enewhall/Mechatronics/connect to Raspberry Pi.txt

ssh pi@169.254.216.2
password: raspberry
