enewhall/Mechatronics/portfolio.html

# 16-778, 18-578, 24-778 Mechatronic Design

# Pre-Tinning Machine

# Project Portfolio

Group G
Eric Newhall (enewhall)
Guillermo Cidre (gmcidre)
Christian Heaney-Secord (cheaneys)
Michael O'Connor (mkoconno)

## Portfolio Overview

- Problem Description
  - Overview
  - Requirements
- System Design
  - Architecture
  - Part Separator
  - Vision Processing
  - Part Placer
  - Tray Positioner
  - Flux and Wire Dispensor
- System Implementation
  - Software
  - Part Separator
  - Vision Processing
  - Part Placer
  - Tray Positioner
  - Flux and Wire Dispensor
- Project Management
  - Team
  - Parts List and Budget
  - Schedule
    - Presenter Schedule
  - Issues Log
- Media
  - Media
- Documents
  - CAD
  - Design Proposal
  - Final Design Proposal
  - Presentations
  - Sequence Diagrams
  - State Charts
  - Lab Reports
