enewhall/Mechatronics/portfolio/new_page_template.html

# Mechatronics - Page Title

16-778, 18-578, 24-778 Spring 2015
Group G
Eric Newhall (enewhall)
Guillermo Cidre (gmcidre)
Christian Heaney-Secord (cheaneys)
Michael O'Connor (mkoconno)

## Title

Remember to change the title in the HTML header.

More contents here.
