enewhall/Mechatronics/portfolio/Media/Media.html

# Mechatronics - Media

16-778, 18-578, 24-778 Spring 2015
Group G
Eric Newhall (enewhall)
Guillermo Cidre (gmcidre)
Christian Heaney-Secord (cheaneys)
Michael O'Connor (mkoconno)

## Pictures

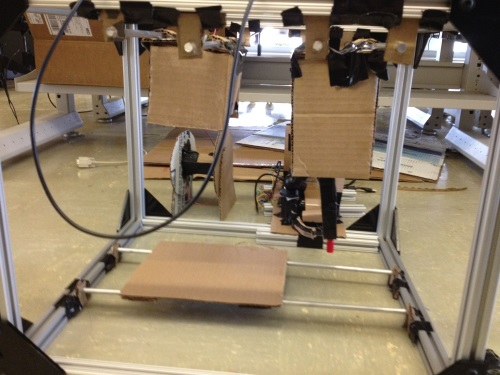
[picture p1: portfolio/Media/mockup1.jpeg]
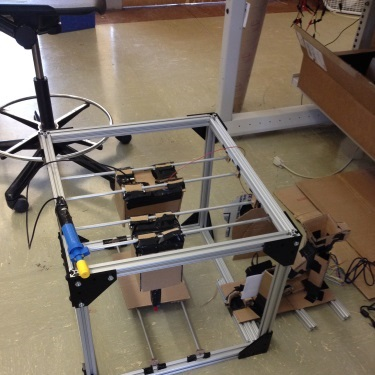
[picture p2: portfolio/Media/mockup2.jpeg]
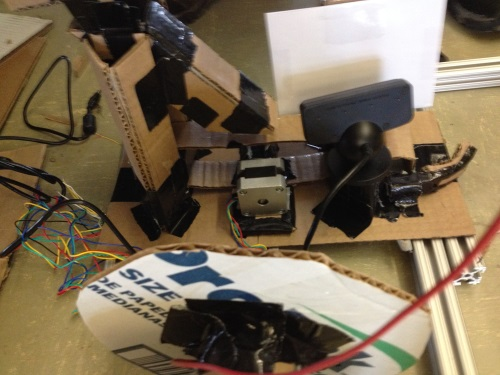
[picture p3: portfolio/Media/mockup3.jpeg]
Mockup (1/3)  | Mockup (2/3)  | Mockup (3/3) 

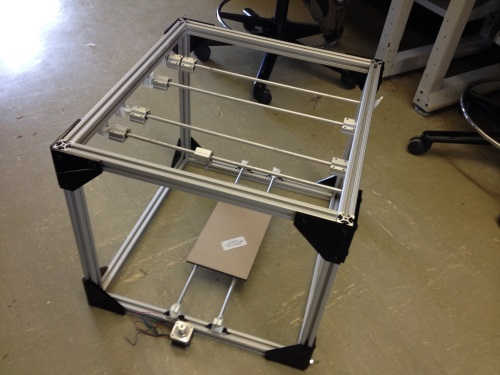
[picture p4: portfolio/Media/Frame_With_Rails.jpeg]
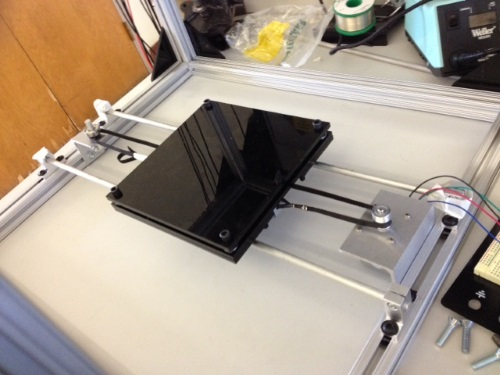
[picture p5: portfolio/Media/rail.JPG]
rail
Frame With Rails  | Rail For Tray System 

Part Placer
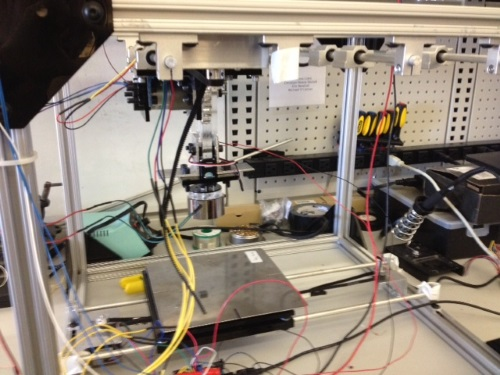
[picture p6: portfolio/Media/part_placer.png]


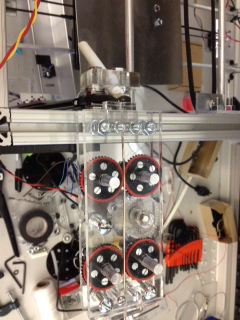
[picture p7: portfolio/Media/wire_feeder.jpeg]
wire_feeder
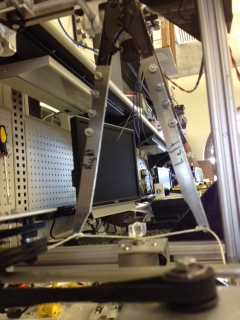
[picture p8: portfolio/Media/wire_cutter.jpeg]
wire_cutter
Wire Feeder  | Wire Cutter 

## Videos

Full Project Demo

(https://youtu.be/HHD21gbO3Bo)
