enewhall/Mechatronics/portfolio/Systems/Systems.html

# Mechatronics - Systems

16-778, 18-578, 24-778 Spring 2015
Group x
Eric Newhall (enewhall)
Guillermo Cidre (gmcidre)
Christian Heaney-Secord (cheaneys)
Michael O'Connor (mkoconno)

## Feeder

## Orienter

## Part Placer

## Flux Placer

## Wire Placer
