enewhall/Mechatronics/portfolio/System_Implementation/Code/Code.html

# Mechatronics - Software

16-778, 18-578, 24-778 Spring 2015
Group G
Eric Newhall (enewhall)
Guillermo Cidre (gmcidre)
Christian Heaney-Secord (cheaneys)
Michael O'Connor (mkoconno)

## Software

Vision Processing Software:
get_BW_image.pi

System Demo Software:
CameraState.ino
FluxDispensorState.ino
LEDState.ino
PartPlacerState.ino
PreTinnerSoftware.ino
revRelState.ino
GlobalVariables.h
SupportFunctionsStructs.h
