enewhall/Mechatronics/portfolio/Documents/State_Charts/State_Charts.html

# Mechatronics - State Charts

16-778, 18-578, 24-778 Spring 2015
Group G
Eric Newhall (enewhall)
Guillermo Cidre (gmcidre)
Christian Heaney-Secord (cheaneys)
Michael O'Connor (mkoconno)

## State Charts

### 1. Camera and Part Seperator

Controls:

- vibration_motor
- conveyer_belt
- flipper_magnet
- flipper_servo

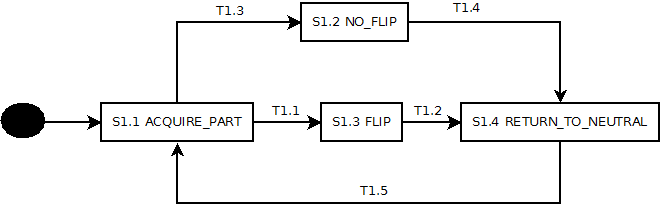
[picture p9: portfolio/Documents/State_Charts/S1.png]


Transition | Condition
T1.1 | image_orientation == 3 || image_orientation == 4
T1.2 | timing
T1.3 | image_orientation == 1 || image_orientation == 2
T1.4 | timing
T1.5 | timing

State | Description | Actions
S1.1 ACQUIRE_PART | Move the conveyer belt until the next part can be seen | vibration_motor = on conveyer_belt = on flipper_magnet = on flipper_servo = off
S1.2 NO_FLIP | Get the part to pick up location | vibration_motor = off conveyer_belt = off flipper_magnet = off flipper_servo = foward
S1.3 FLIP | Flip the part to pick up location | vibration_motor = off conveyer_belt = off flipper_magnet = on flipper_servo = foward
S1.4 RETURN_TO_NEUTRAL | Move servo back to initial position | vibration_motor = off conveyer_belt = off flipper_magnet = off flipper_servo = reverse

### 2. Part Placer

Controls:

- placer_rail
- dc_rack
- placer_magnet
- placer_servo
- tray_rail

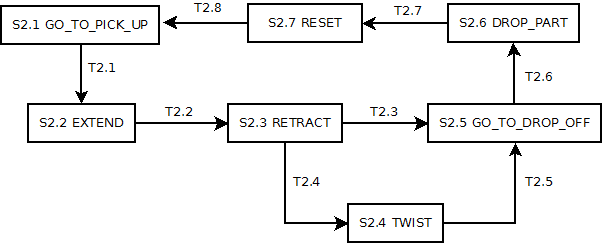
[picture p10: portfolio/Documents/State_Charts/S2.png]


Transition | Condition
T2.1 | placer_loc == PICK_UP_LOC && image_orientation != 0
T2.2 | timing
T2.3 | (image_orientation == 1 || image_orientation == 3) && placer_limit_switch == true
T2.4 | (image_orientation == 2 || image_orientation == 4) && placer_limit_switch == true
T2.5 | placer_loc == DROP_OFF_LOC
T2.6 | timing && tray_loc == TRAY_DROP_OFF
T2.7 | timing
T2.8 | placer_limit_switch == true

State | Description | Actions
S2.1 GO_TO_PICK_UP | move rail to pick up location by camera and wait for part | placer_rail = move to pick up dc_rack = off placer_magnet = off placer_servo = off tray_rail = move to working pos
S2.2 EXTEND | lower arm to grab part | placer_rail = move to pick up dc_rack = lower placer_magnet = off placer_servo = off tray_rail = move to working pos
S2.3 RETRACT | raise arm holding part | placer_rail = move to pick up dc_rack = raise placer_magnet = on placer_servo = off tray_rail = move to working pos
S2.4 TWIST | rotate arm 180 degrees to correct orientation | placer_rail = move to pick up dc_rack = off placer_magnet = on placer_servo = on tray_rail = move to working pos
S2.5 GO_TO_DROP_OFF | move tray and part placer to correct location | placer_rail = move to drop off dc_rack = off placer_magnet = on placer_servo = off tray_rail = move to tray drop
S2.6 DROP_PART | place part on tray | placer_rail = move to drop off dc_rack = lower placer_magnet = on placer_servo = off tray_rail = move to tray drop
S2.7 RESET | place part on tray | placer_rail = move to drop off dc_rack = raise placer_magnet = off placer_servo = off tray_rail = move to tray drop
