enewhall/Mechatronics/portfolio/Project_Management/Team/Team.html

# Mechatronics - Team

16-778, 18-578, 24-778 Spring 2015
Group G
Eric Newhall (enewhall)
Guillermo Cidre (gmcidre)
Christian Heaney-Secord (cheaneys)
Michael O'Connor (mkoconno)

## Team

### Guillermo Cidre(ECE) - Analog design and serial communications

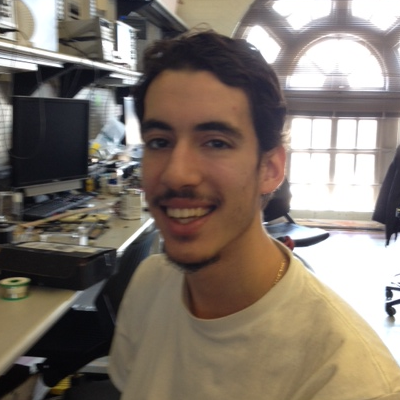
[picture p11: portfolio/Project_Management/Team/gc.png]
Guillermo Cidre


### Michael O'Connor(MechE) - Flux dispenser and wire cutting and placement

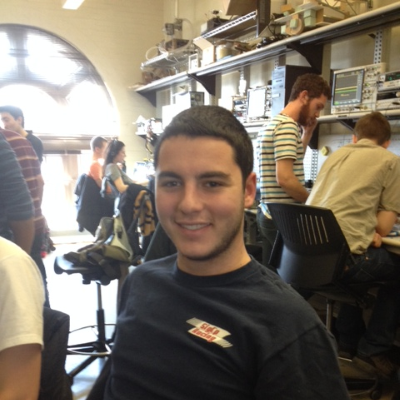
[picture p12: portfolio/Project_Management/Team/mo.png]
Michael O'Connor


### Christian Heaney-Secord(MechE) - Hopper design and part oreientor

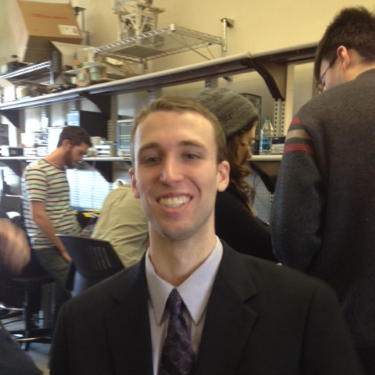
[picture p13: portfolio/Project_Management/Team/ch.png]
Christian Heaney-Secord


### Eric Newhall(ECE) - Vision processing and website design

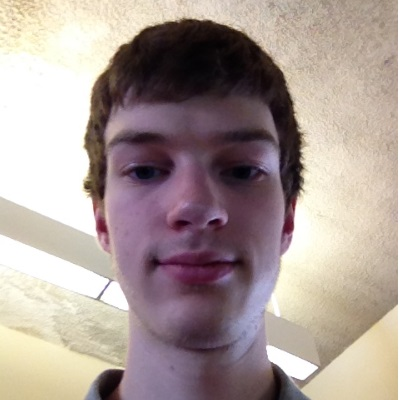
[picture p14: portfolio/Project_Management/Team/en.png]
Eric Newhall
