enewhall/Mechatronics/portfolio/Project_Management/Schedule/Schedule.html

# Mechatronics - Schedule

16-778, 18-578, 24-778 Spring 2015
Group G
Eric Newhall (enewhall)
Guillermo Cidre (gmcidre)
Christian Heaney-Secord (cheaneys)
Michael O'Connor (mkoconno)

## Schedule

Due Date | Project | Leader
Feb 1 | Complete parts order | All
Feb 1 | Prototype hopper | Christian Heaney-Secord
Feb 8 | Migrate deisgn proposal info to website | Eric Newhall
Feb 8 | Test vision processing system | Eric Newhall
Feb 15 | Serial communication between RP and Arduino | Guillermo Cidre
Feb 15 | Build and test electromagnet part placer | Christian Heaney-Secord
Feb 22 | Wire and test stepper motors | Guillermo Cidre
Feb 22 | Complete part re-orientator and integrate with hopper | Christian Heaney-Secord
March 1 | Complete conveyor belt | Christian Heaney-Secord
March 1 | Finalize vision processing | Eric Newhall
March 1 | Midsemester Presentations | All
March 8 | Complete rail systems | Michael O'Connor
March 8 | Complete tray positioner | Christian Heaney-Secord
March 15 | Spring Break | Off
March 22 | Prototype flux extruder | Michael O'Connor
March 22 | Complete and integrate part placer | Christian Heaney-Secord
March 29 | Complete and test wire cutting mechanism | Michael O'Connor
April 5 | Integrate flux extruder and wire cutter onto rails | Michael O'Connor
April 12 | Test and calibrate system | All
April 19 | Replace original prototypes with refined parts | Michael O'Connor
April 26 | Re-calibrate and test extensively | All
May 3 | Prepare final report and presentation | All
