enewhall/Mechatronics/portfolio/Documents/Sequence_Diagrams/Sequence_Diagrams.html

# Mechatronics - Sequence Diagrams

16-778, 18-578, 24-778 Spring 2015
Group G
Eric Newhall (enewhall)
Guillermo Cidre (gmcidre)
Christian Heaney-Secord (cheaneys)
Michael O'Connor (mkoconno)

## Use Cases

- 1.1 Move part from separator to camera
- 2.1 Pick up part from camera (correct orientation)
- 2.2 Pick up part from camera (180 degrees flipped)
- 2.3 Pick up part from camera (upsidedown)
- 2.4 Pick up part from camera (upsidedown and 180 degrees flipped)
- 3.1 Place part on tray
- 4.1 Place flux on part
- 5.1 Dispense wire onto part

### 1.1 Move part from separator to camera

#### Initial Conditions

- Part is in hopper
- Vibration motor is off
- Conveyer belt is stationary

#### Final Conditions

- Part is in frint of camera
- Vibration motor is off
- Conveyer belt is stationary

#### Sequence Diagram

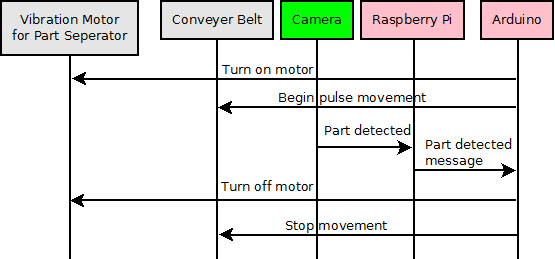
[picture p15: portfolio/Documents/Sequence_Diagrams/D1_1.png]
D1.1


### 2.1 Pick up part from camera (correct orientation)

#### Initial Conditions

- Part is front of camera in correct orientation
- Magnet for part placer is off
- Flipper Magnet is on
- Part placer located over tray
- Placer arm is retracted
- Flipper in neutral position

#### Final Conditions

- Magnet for part placer is on
- Flipper Magnet is on
- Part placer located over camera
- Placer arm is retracted
- Flipper in neutral position

#### Sequence Diagram

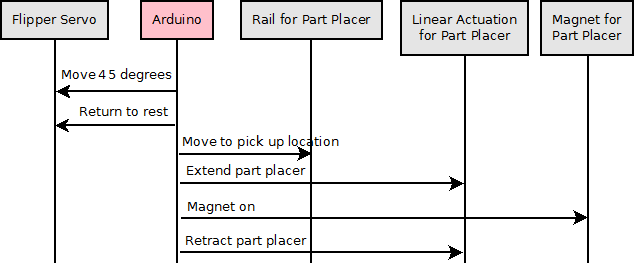
[picture p16: portfolio/Documents/Sequence_Diagrams/D2_1.png]
D2.1


### 2.2 Pick up part from camera (180 degrees flipped)

#### Initial Conditions

- Part is front of camera but is 180 degrees flipped
- Magnet for part placer is off
- Flipper Magnet is on
- Part placer located over tray
- Placer arm is retracted
- Flipper in neutral position

#### Final Conditions

- Magnet for part placer is on
- Flipper Magnet is on
- Part placer located over camera
- Placer arm is retracted
- Flipper in neutral position

#### Sequence Diagram

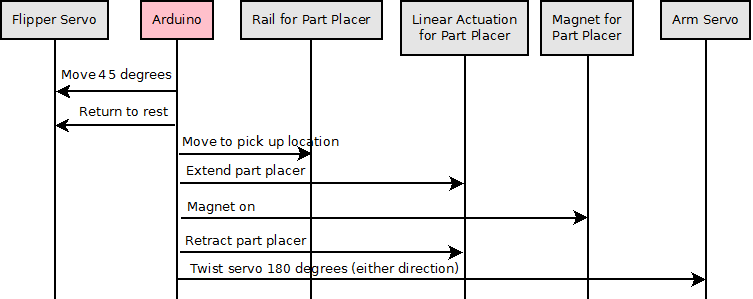
[picture p17: portfolio/Documents/Sequence_Diagrams/D2_2.png]
D2.2


### 2.3 Pick up part from camera (upsidedown)

#### Initial Conditions

- Part is front of camera but upsidedown
- Magnet for part placer is off
- Flipper Magnet is on
- Part placer located over tray
- Placer arm is retracted
- Flipper in neutral position

#### Final Conditions

- Magnet for part placer is on
- Flipper Magnet is on
- Part placer located over camera
- Placer arm is retracted
- Flipper in neutral position

#### Sequence Diagram

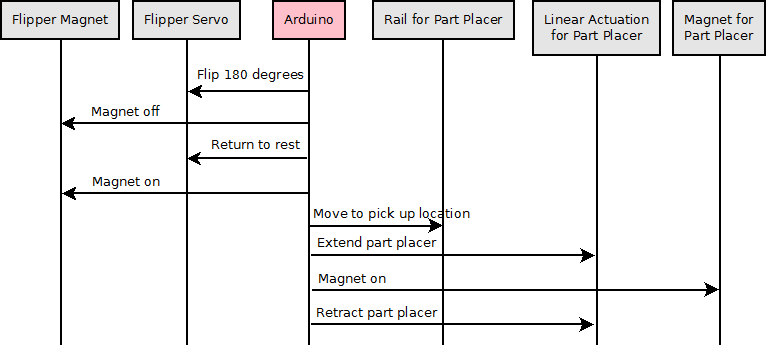
[picture p18: portfolio/Documents/Sequence_Diagrams/D2_3.png]
D2.3


### 2.4 Pick up part from camera (upsidedown and 180 degrees flipped)

#### Initial Conditions

- Part is front of camera but upsidedown and 180 degrees flipped
- Magnet for part placer is off
- Flipper Magnet is on
- Part placer located over tray
- Placer arm is retracted
- Flipper in neutral position

#### Final Conditions

- Magnet for part placer is on
- Flipper Magnet is on
- Part placer located over camera
- Placer arm is retracted
- Flipper in neutral position

#### Sequence Diagram

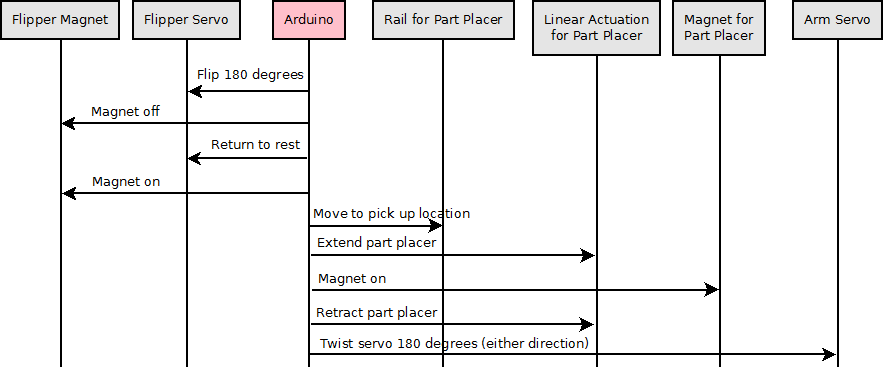
[picture p19: portfolio/Documents/Sequence_Diagrams/D2_4.png]
D2.4


### 3.1 Place part on tray

#### Initial Conditions

- part is being held by magnet
- part is correct orientation
- linear actuator is retracted

#### Final Conditions

- magnet is off
- part is on tray
- linear actuator is retracted

#### Sequence Diagram

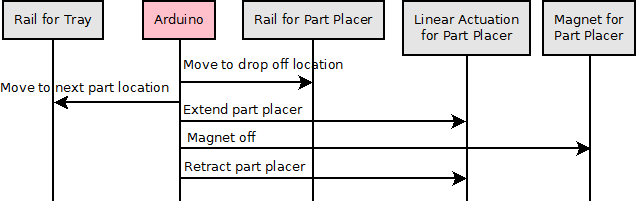
[picture p20: portfolio/Documents/Sequence_Diagrams/D3_1.png]
D3.1


### 4.1 Place flux on part

#### Initial Conditions

- Tray is in front of part placer
- Part has no flux or wire on it

#### Final Conditions

- Tray is in front of flux and wire dispensor
- part has flux and needs wire

#### Sequence Diagram

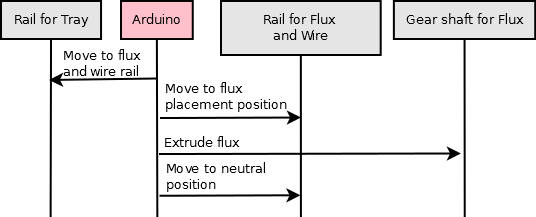
[picture p21: portfolio/Documents/Sequence_Diagrams/D4_1.png]


### 5.1 Dispense wire onto part

#### Initial Conditions

- Tray is in front of flux and wire dispensor
- Part has flux and needs wire

#### Final Conditions

- Tray is in front of flux and wire dispensor
- Part has flux and wire

#### Sequence Diagram

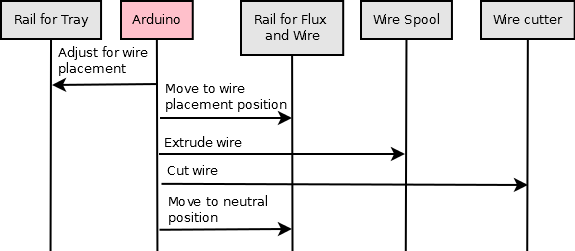
[picture p22: portfolio/Documents/Sequence_Diagrams/D5_1.png]
