enewhall/Mechatronics/portfolio/Problem_Description/Overview/Overview.html

# Mechatronics - Overview

16-778, 18-578, 24-778 Spring 2015
Group G
Eric Newhall (enewhall)
Guillermo Cidre (gmcidre)
Christian Heaney-Secord (cheaneys)
Michael O'Connor (mkoconno)

## Overview

Kennametal is an American supplier of tooling and industrial materials that has a
plant in Victoria, British Columbia, Canada that manufactures saw tips and prepares
them for attachment to a handle through a process known as pre-tinning. In this process
a dab of flux is applied to the surface of a carbide saw tip and then two silver wires
are carefully placed in the flux, oriented along the major diagonal of the saw tip. Once
this process is complete, tinning can occur, in which the wires melt onto the saw tip in
an oven.

The process of pre-tinning saw tips is laborious and meticulous because of the size of
the saw tips and wires that are handled. This work also can have negative health effects
as the repetitive motion can cause strain injuries. Our objective is to design and build
a mechatronic system capable of pre-tinning saw tips, removing the need for this task to
be accomplished manually. In doing so the potential for worker injury will be greatly
reduced, the small wires can be placed with greater accuracy, and there is the potential
that the machine may be able to perform the task significantly faster than a worker.

See Project Requirements
