enewhall/Mechatronics/portfolio/Problem_Description/Requirements/Requirements.html

# Mechatronics - Requirements

16-778, 18-578, 24-778 Spring 2015
Group G
Eric Newhall (enewhall)
Guillermo Cidre (gmcidre)
Christian Heaney-Secord (cheaneys)
Michael O'Connor (mkoconno)

## Explicit Design Requirements:

- 20 parts must be processed in <=5 minutes
- Flux dab must be centered on the part-top centroid and cover 1/4 to 1/3 of the part-top’s surface area
- Must be able to handle at least two different part sizes
- Machine fits within 2’x2’x2’
- The two wires must be placed side by side in the flux dab such that:
  1. Their orientation is along the major diagonal to w/in 5°;
  2. There is no space between them laterally;
  3. Their longitudinal misalignment is <=10%
- The parts will be deposited on a flat output tray in 4 rows of 5 parts each, with the part-tops facing up. Part edges should be at least 1/2” away from the tray edge, and there should be at least 1/4” spacing between the edges of adjacent parts.
- No more than 5% of wires detached or wrongly positioned

## Implied Design Requirements:

- Machine is durable enough such that it can endure a harsh factory environment
- The machine will have a robust design to accommodate any changes or additional requirements of the pre-tinning process
- Design is simple enough such that the basics of the machine will be understood by an assembly worker
- Design will allow easy access for a worker to fix the machine in the event of failure
- Designed such that if a local failure occurs within the machine the remaining functions of the machine will not be compromised
