enewhall/Mechatronics/Labs/Sensor Lab/Potentiometer_notes.pdf

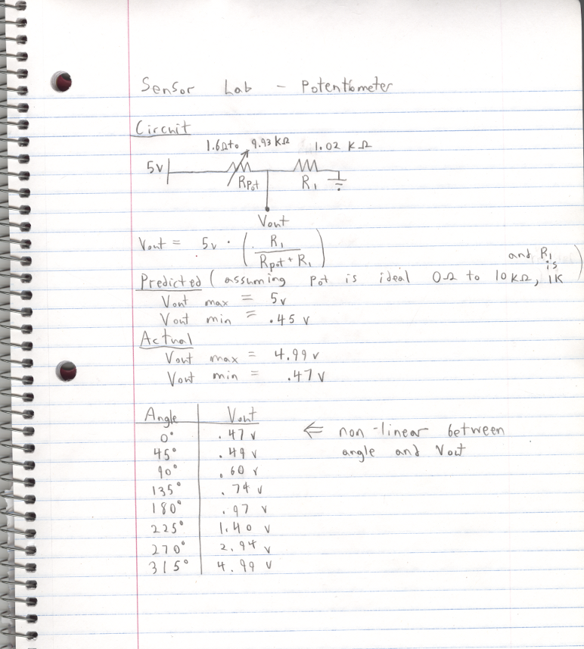
[picture p93: figure]
