enewhall/Mechatronics/Labs/Motor Lab/image(1).jpeg

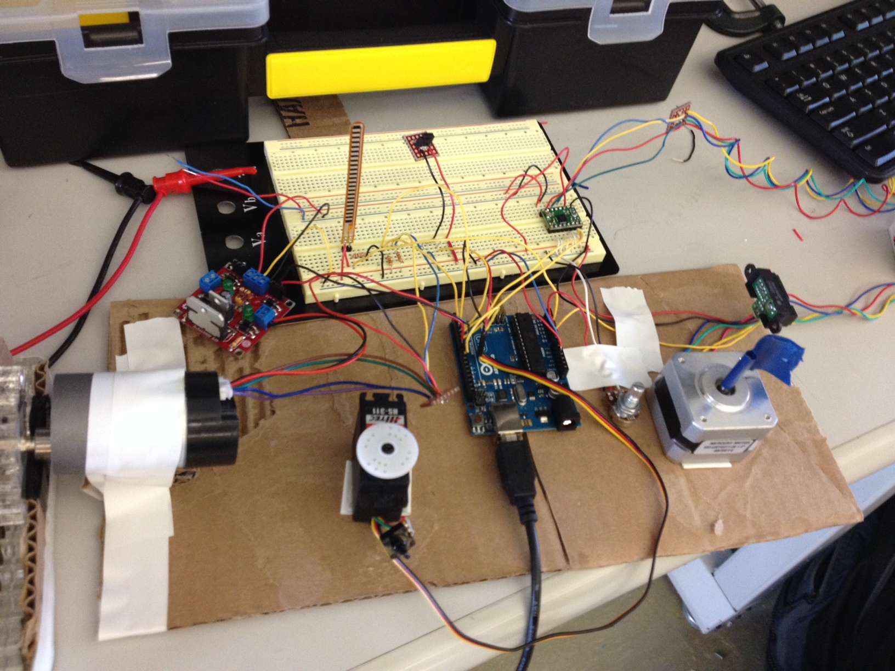
Labs/Motor Lab/image(1).jpeg
