enewhall/Mechatronics/Labs/Sensor Lab/Flex_Sensor_Notes.png

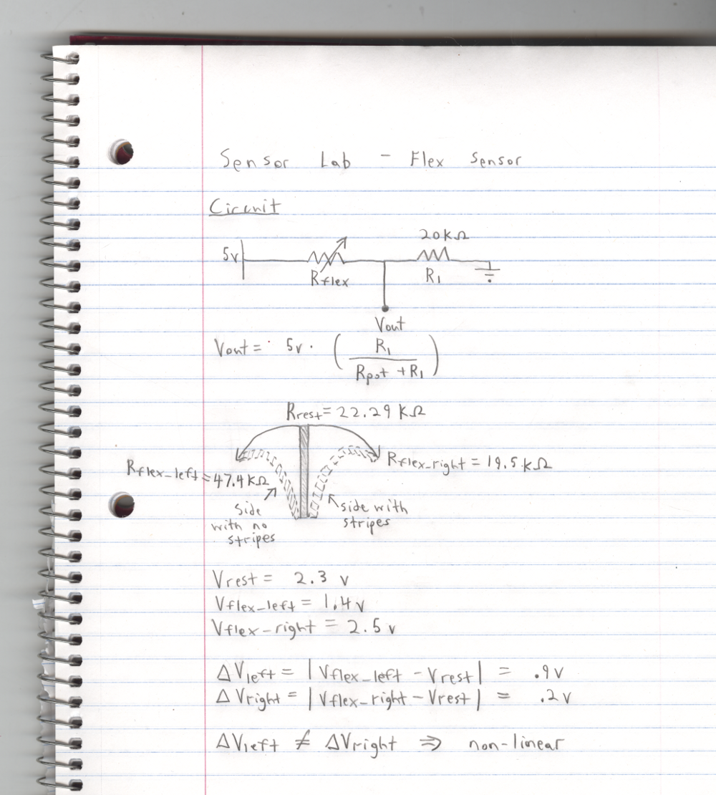
Labs/Sensor Lab/Flex_Sensor_Notes.png
