enewhall/Mechatronics/Labs/Sensor Lab/IRsensor_graph.png

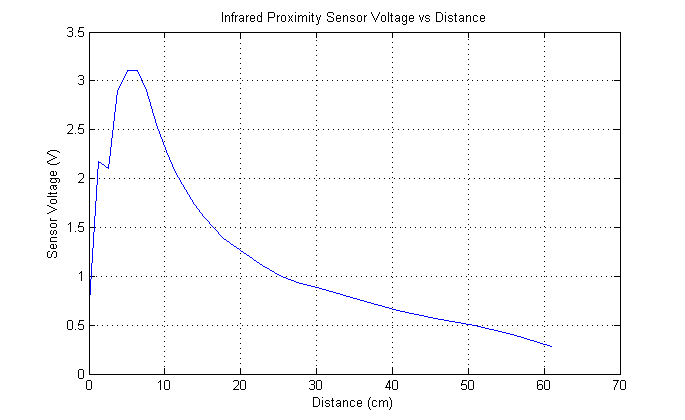
Labs/Sensor Lab/IRsensor_graph.png
