enewhall/Mechatronics/Labs/systemDemo1/State Diagram.bmp

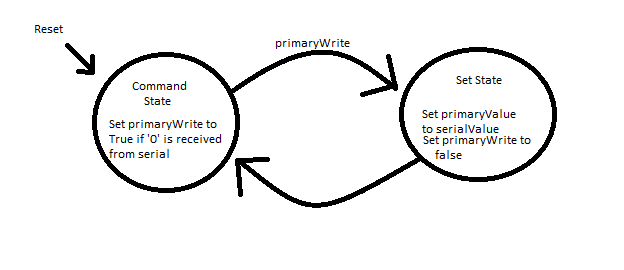
Labs/systemDemo1/State Diagram.bmp
