enewhall/Mechatronics/Labs/systemDemo2/State Diagram.bmp

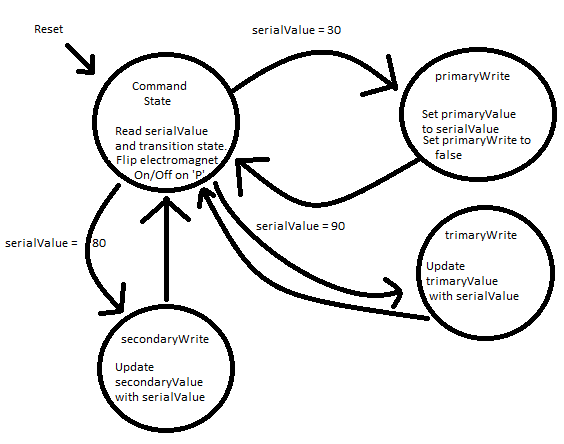
Labs/systemDemo2/State Diagram.bmp
