enewhall/Mechatronics/Labs/systemDemo8/Vision Processing/temp1c.png

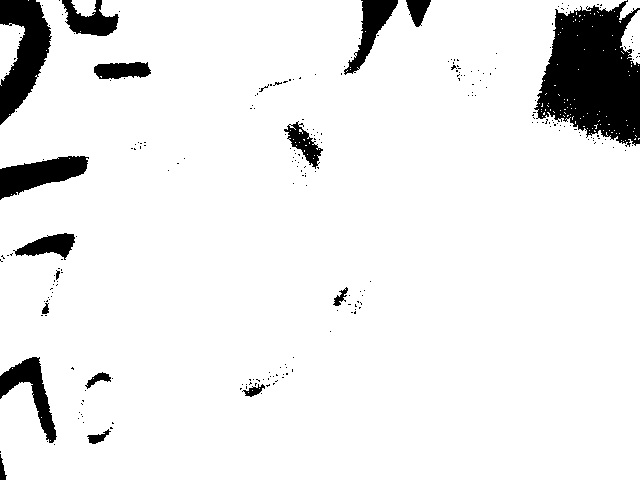
Labs/systemDemo8/Vision Processing/temp1c.png
