enewhall/Mechatronics/portfolio/Documents/Pictures/iso1.JPG

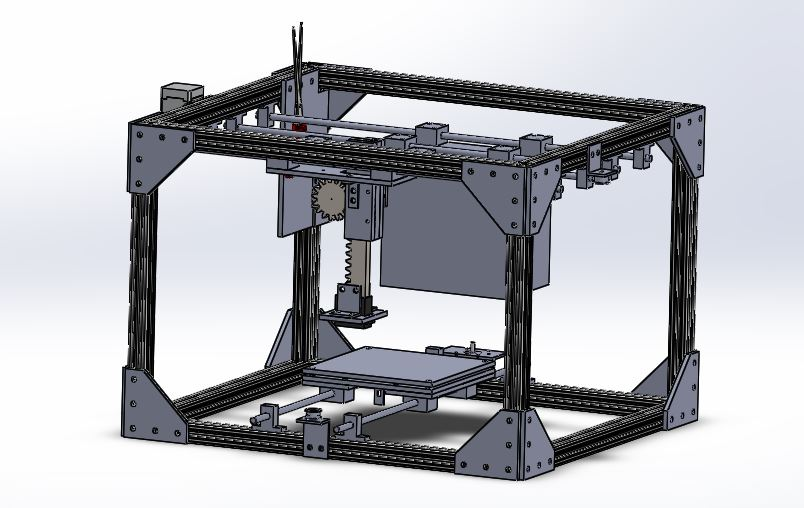
portfolio/Documents/Pictures/iso1.JPG
