enewhall/Mechatronics/portfolio/Documents/Pictures/iso2.JPG

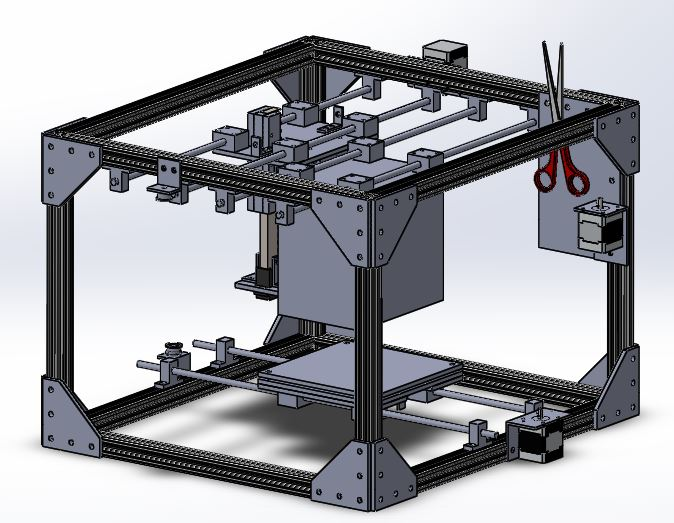
portfolio/Documents/Pictures/iso2.JPG
