enewhall/Mechatronics/portfolio/System_Design/System_Diagrams/Flux_and_Wire_Dispensor.png

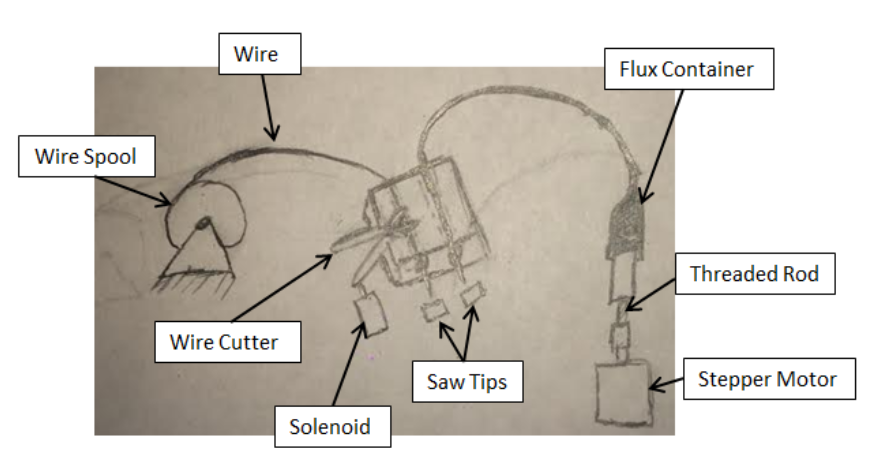
portfolio/System_Design/System_Diagrams/Flux_and_Wire_Dispensor.png
