enewhall/Mechatronics/portfolio/System_Design/System_Diagrams/Part_Placer.png

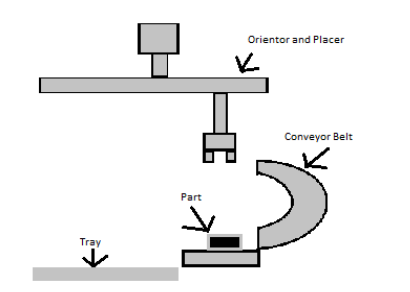
portfolio/System_Design/System_Diagrams/Part_Placer.png
