enewhall/Mechatronics/portfolio/System_Design/System_Diagrams/Tray_Positioner.png

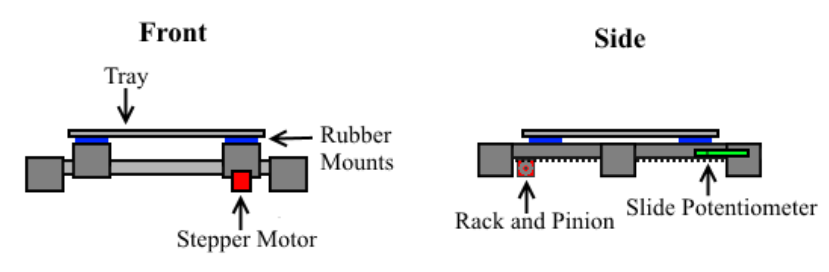
portfolio/System_Design/System_Diagrams/Tray_Positioner.png
