enewhall/Mechatronics/portfolio/System_Design/System_Diagrams/Vision_Processing.png

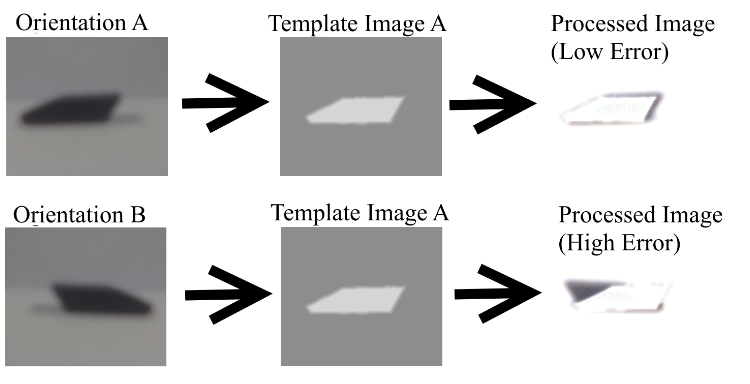
portfolio/System_Design/System_Diagrams/Vision_Processing.png
