enewhall/Mechatronics/portfolio/System_Implementation/Part_Placer/IMG_0036.JPG

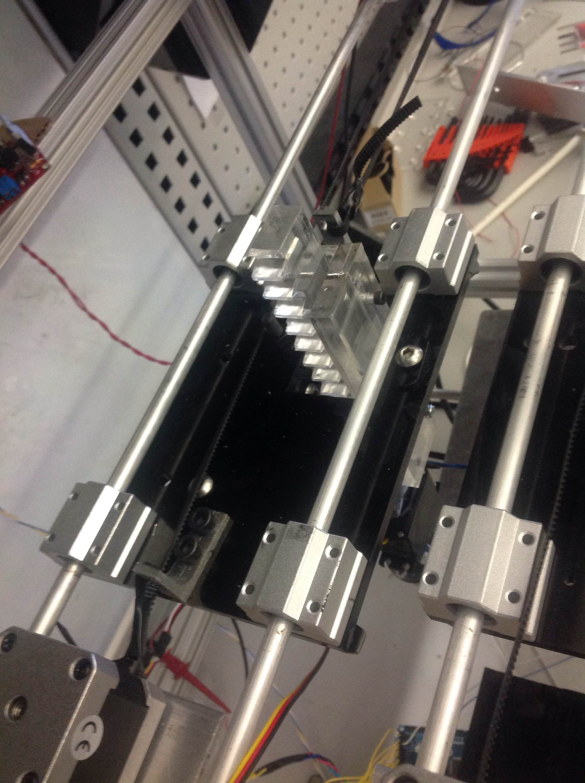
portfolio/System_Implementation/Part_Placer/IMG_0036.JPG
