enewhall/Mechatronics/portfolio/System_Implementation/Part_Placer/IMG_0038.JPG

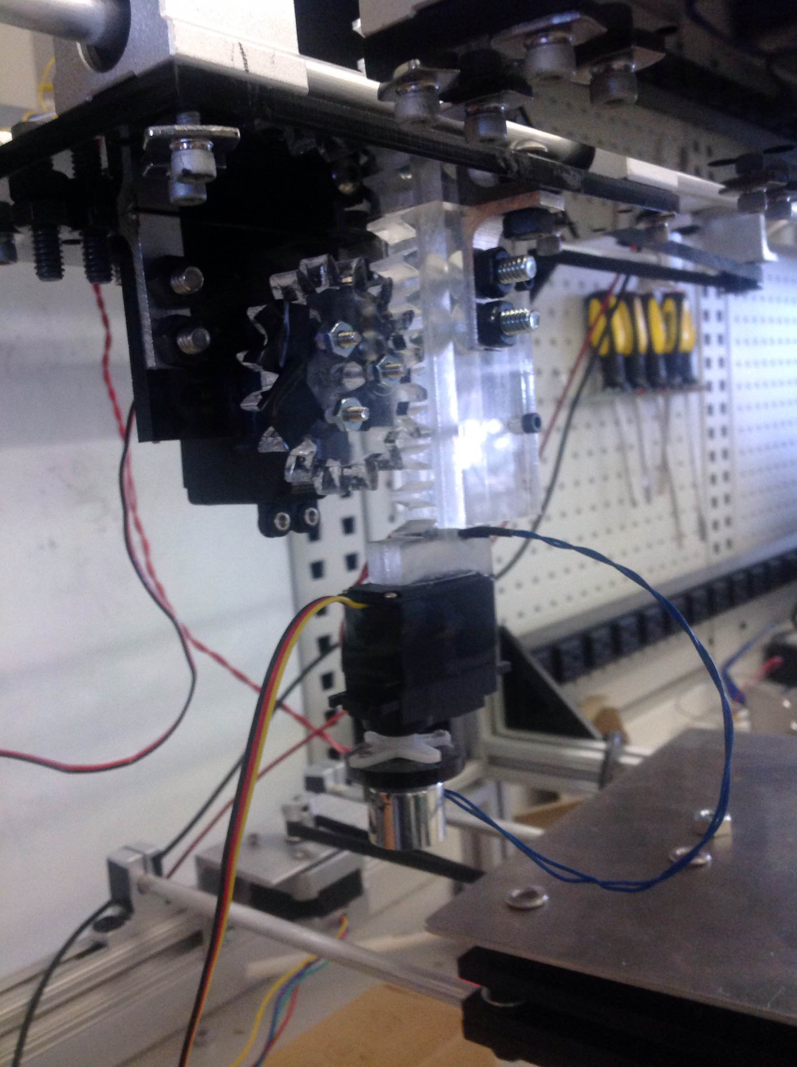
portfolio/System_Implementation/Part_Placer/IMG_0038.JPG
