enewhall/Mechatronics/portfolio/System_Implementation/Part_Placer/IMG_0044.JPG

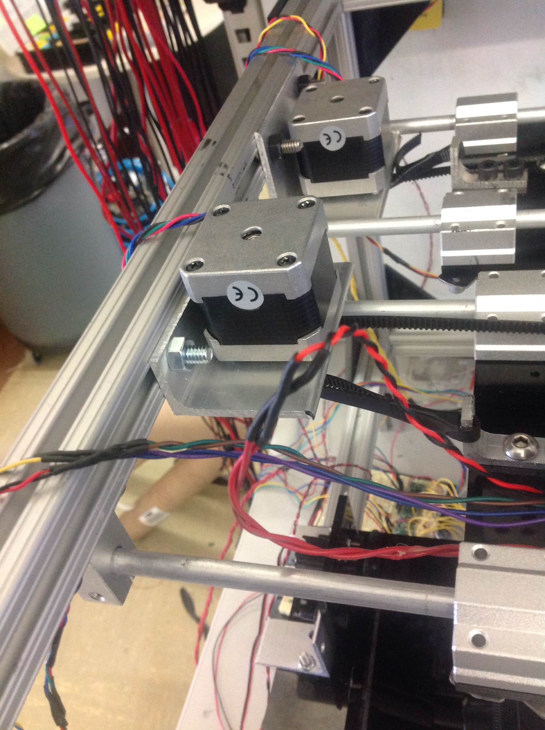
portfolio/System_Implementation/Part_Placer/IMG_0044.JPG
