enewhall/Mechatronics/portfolio/System_Implementation/wire_feeder.png

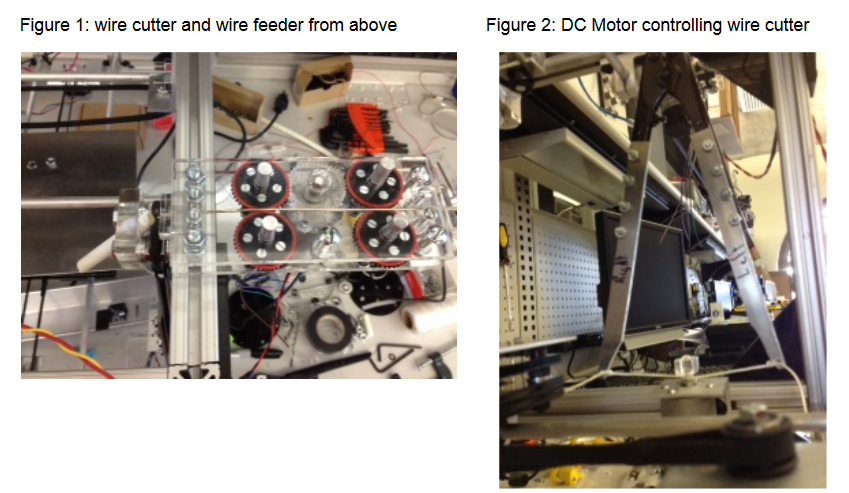
portfolio/System_Implementation/wire_feeder.png
