enewhall/Mechatronics/portfolio/Documents/CAD/8020 frame/frame_asm.SLDASM

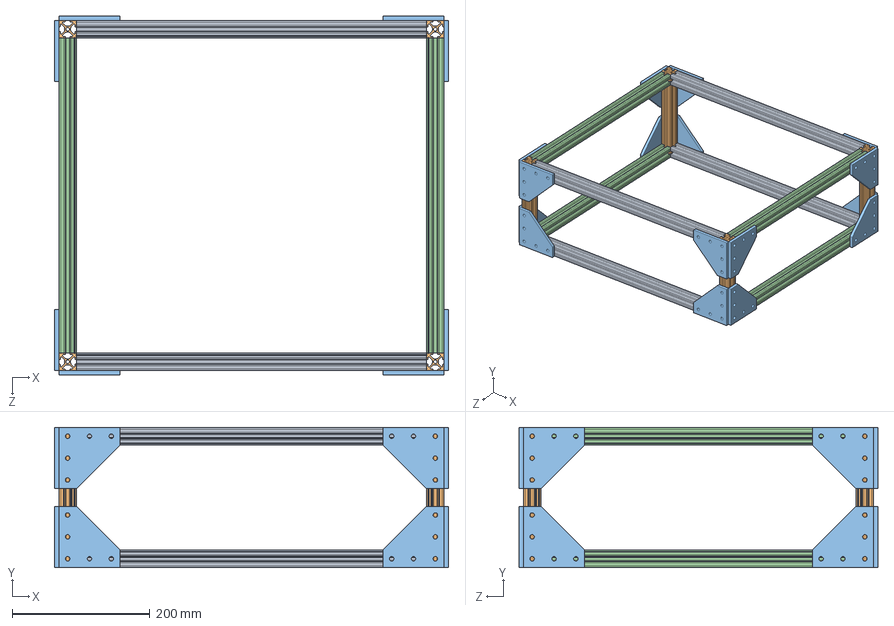
[picture p110: CAD file, 2015-03-21]
portfolio/Documents/CAD/8020 frame/frame_asm.SLDASM
571.5 x 203.2 x 520.7 mm
8020-20in x 4
8020-12in x 4
corner bracket x 16
8020-18in x 4
