enewhall/Mechatronics/portfolio/Documents/CAD/idler pulley/idler pulley.SLDASM

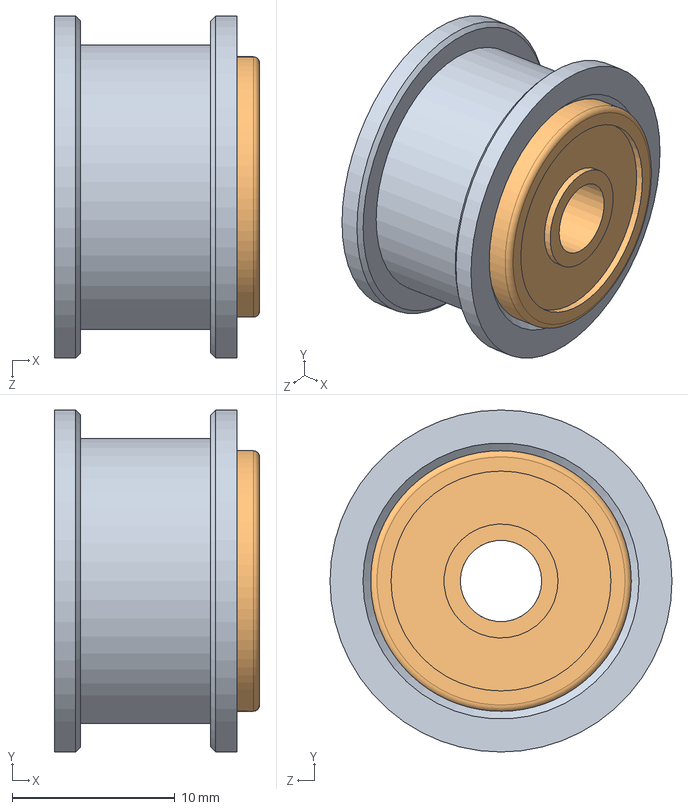
[picture p111: CAD file, 2015-03-21]
portfolio/Documents/CAD/idler pulley/idler pulley.SLDASM
12.6 x 21.0 x 21.0 mm
B17023
BEARING_5_16_5 x 2
B18026
