enewhall/Mechatronics/portfolio/Documents/CAD/part placer asm/part placer asm.SLDASM

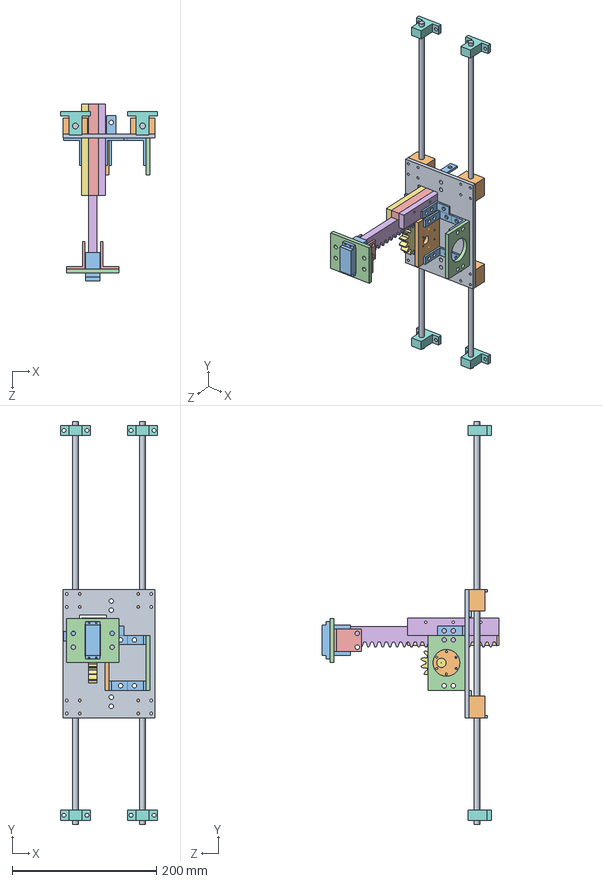
[picture p112: CAD file, 2015-03-23]
portfolio/Documents/CAD/part placer asm/part placer asm.SLDASM
135.0 x 558.8 x 245.7 mm
mounting plate
front motor plate
gearmotor mounting brackets x 8
rear motor plate
rack back plate
rack right plate
rack left plate
Linear Rail Shaft Guide x 4
8mm rod x 2
linear bearing platform x 4
servo
servo mount
servo mounting brackets x 2
rack spur rectangular_ai
spur gear_ai
