enewhall/Mechatronics/portfolio/Documents/CAD/V2.SLDASM

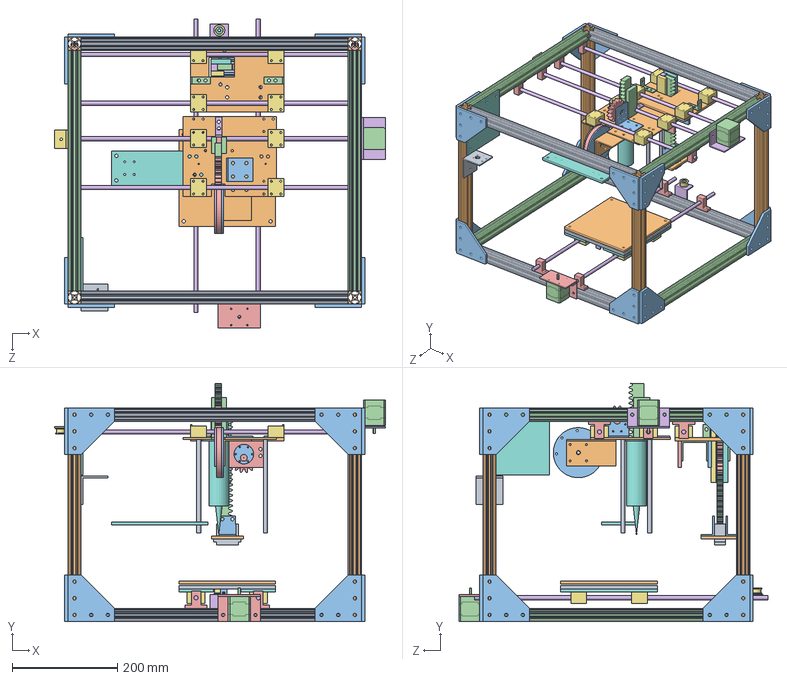
[picture p113: CAD file, 2015-03-23]
portfolio/Documents/CAD/V2.SLDASM
629.7 x 453.2 x 588.0 mm
8020-20in x 4
8020-12in x 4
corner bracket x 16
8020-18in x 4
Linear Rail Shaft Guide x 12
8mm rod x 6
linear bearing platform x 12
bottom plate x 3
middle plate
top layer
L-bracket belt mount x 2
stepper motor x 2
L-bracket motor mount
L-bracket idler mount
B17023 x 2
BEARING_5_16_5 x 2
B18026
mounting plate
front motor plate
gearmotor mounting brackets x 8
rear motor plate
rack back plate
rack right plate
rack left plate
servo
servo mount
servo mounting brackets x 2
rack spur rectangular_ai x 2
spur gear_ai x 2
L-bracket motor mount-part placer
L-bracket idler mount-part placer
bolt cutter plate
l-bracket gearmotor wire cutter
flux-wire rails base
front motor plate-flux extruder
rack side plates x 2
rack back plate - flux
rear rack brace l bracket
syringe piston
syringe
large 8mm standoff x 4
l-bracket gearmotor revolver
Revolver_motor_plate
Revolver_45deg
Revolver_motor_plate_middle
Revolver_motor_plate2
