enewhall/Mechatronics/portfolio/Documents/CAD/bottom rails asm/rails_asm-bottom.SLDASM

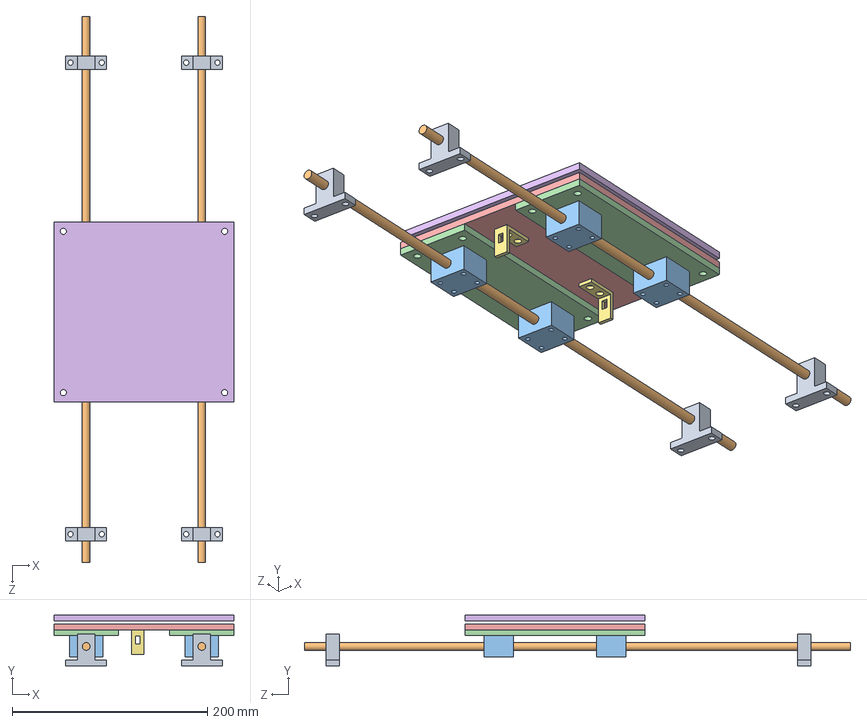
[picture p114: CAD file, 2015-03-21]
portfolio/Documents/CAD/bottom rails asm/rails_asm-bottom.SLDASM
184.2 x 52.2 x 558.8 mm
Linear Rail Shaft Guide x 4
8mm rod x 2
linear bearing platform x 4
bottom plate x 2
middle plate
top layer
L-bracket belt mount x 2
