enewhall/Mechatronics/portfolio/Documents/CAD/flux-wire asm/flux wire asm.SLDASM

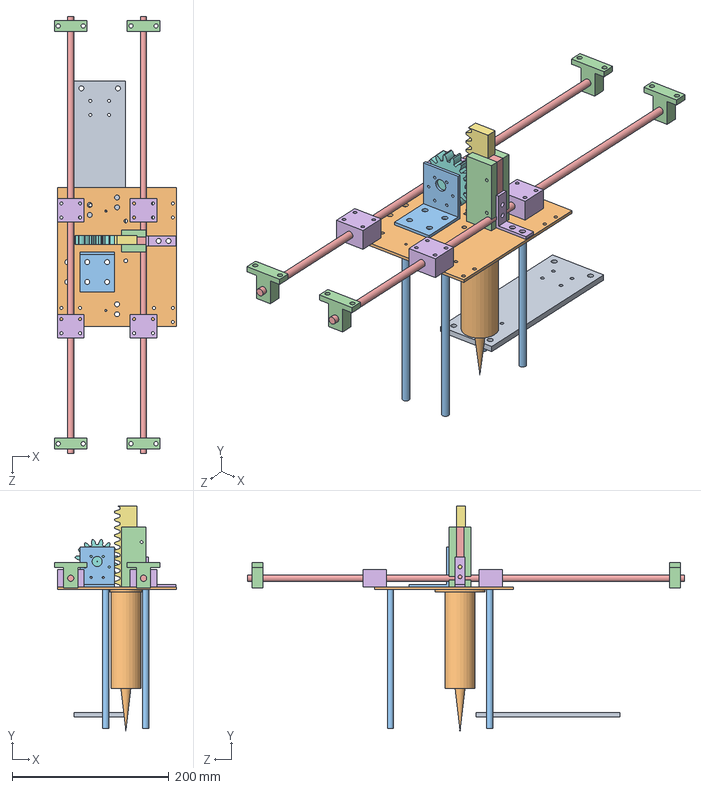
[picture p115: CAD file, 2015-03-23]
portfolio/Documents/CAD/flux-wire asm/flux wire asm.SLDASM
156.4 x 287.4 x 558.8 mm
flux-wire rails base
front motor plate-flux extruder
rack side plates x 2
rack back plate - flux
rear rack brace l bracket
rack spur rectangular_ai
spur gear_ai
syringe piston
syringe
large 8mm standoff x 4
bottom plate
Linear Rail Shaft Guide x 4
8mm rod x 2
linear bearing platform x 4
