enewhall/Mechatronics/portfolio/Documents/CAD/flux-wire asm/rails_asm-flux.SLDASM

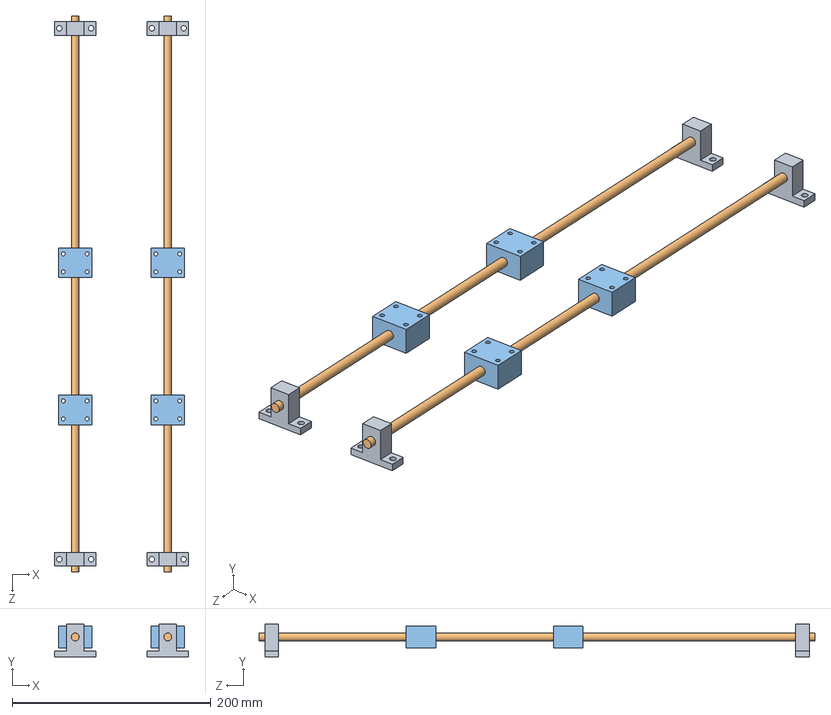
[picture p116: CAD file, 2015-03-21]
portfolio/Documents/CAD/flux-wire asm/rails_asm-flux.SLDASM
135.0 x 32.8 x 558.8 mm
Linear Rail Shaft Guide x 4
8mm rod x 2
linear bearing platform x 4
