enewhall/Mechatronics/portfolio/Documents/CAD/bottom rails asm/rails_asm.SLDASM

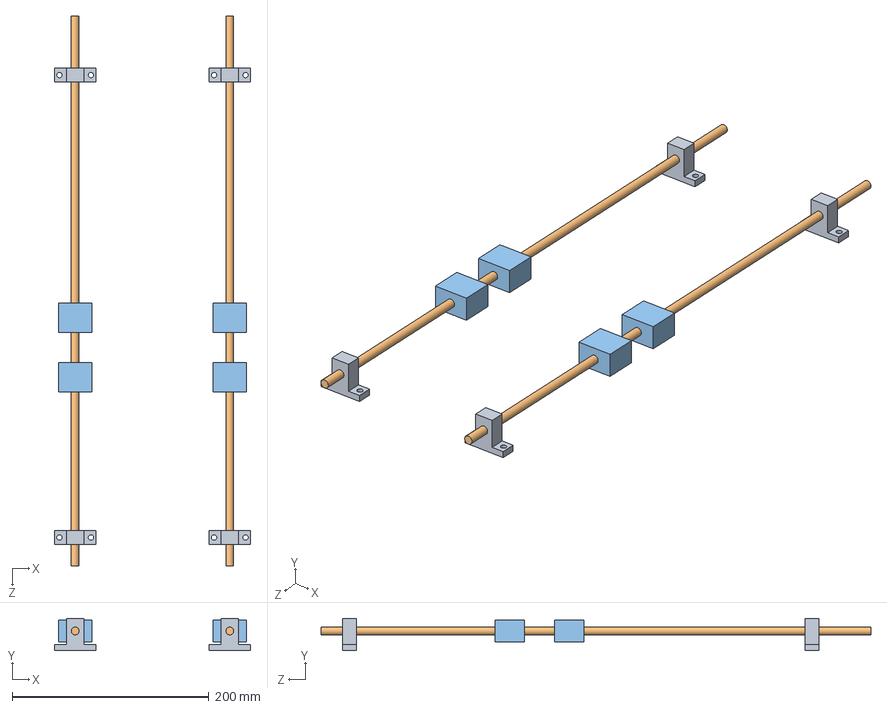
[picture p117: CAD file, 2015-02-16]
portfolio/Documents/CAD/bottom rails asm/rails_asm.SLDASM
199.1 x 32.8 x 558.8 mm
Linear Rail Shaft Guide x 4
8mm rod x 2
linear bearing platform x 4
