enewhall/Mechatronics/portfolio/Documents/CAD/wire cutter/wire feeder asm.SLDASM

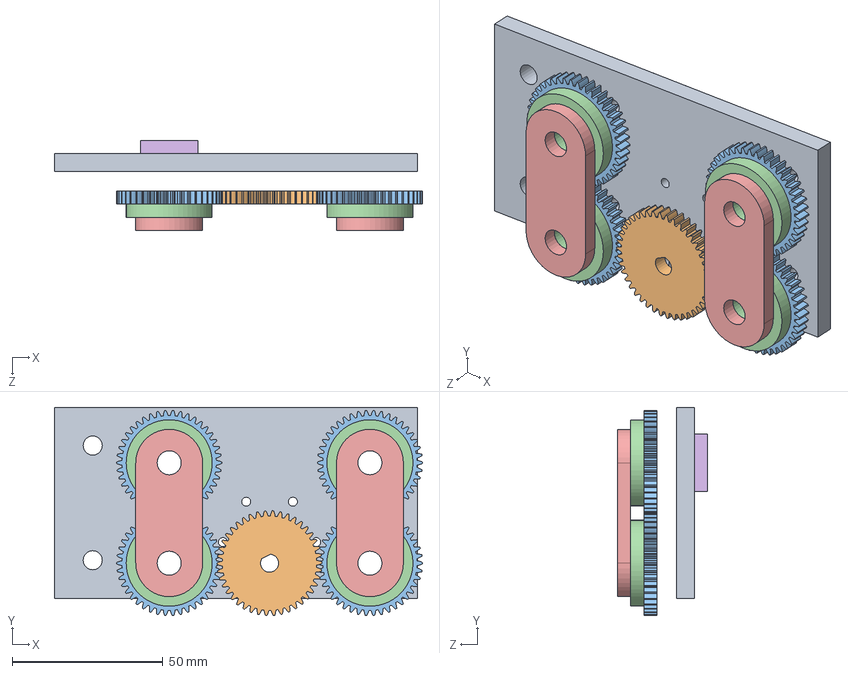
[picture p118: CAD file, 2015-03-23]
portfolio/Documents/CAD/wire cutter/wire feeder asm.SLDASM
122.2 x 69.2 x 29.9 mm
wire feeder mounting plate
gearmotor gear
8mm gear x 4
feeder pulley x 4
shaft aligner x 2
v2 arcyrlic spacer
