enewhall/Mechatronics/portfolio/Documents/CAD/base asm/top layer.SLDPRT

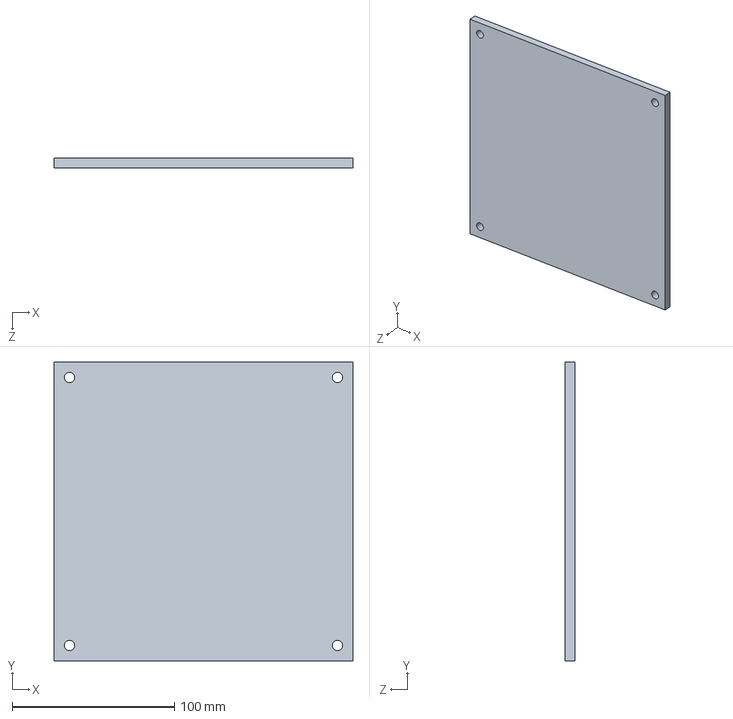
[picture p119: CAD file, 2015-03-01]
portfolio/Documents/CAD/base asm/top layer.SLDPRT
184.1 x 184.1 x 5.99 mm
