enewhall/Mechatronics/portfolio/Documents/CAD/bottom rails asm/linear bearing platform.SLDPRT

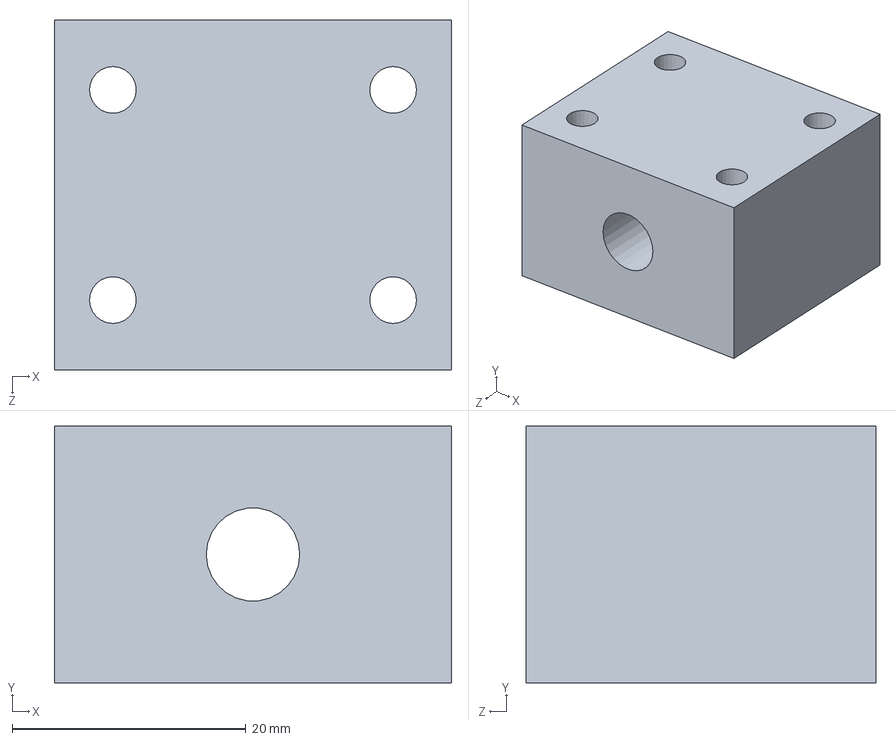
[picture p120: CAD file, 2015-03-21]
portfolio/Documents/CAD/bottom rails asm/linear bearing platform.SLDPRT
34.0 x 22.0 x 30.0 mm
