enewhall/Mechatronics/portfolio/Documents/CAD/flux-wire asm/flux-wire rails base.SLDPRT

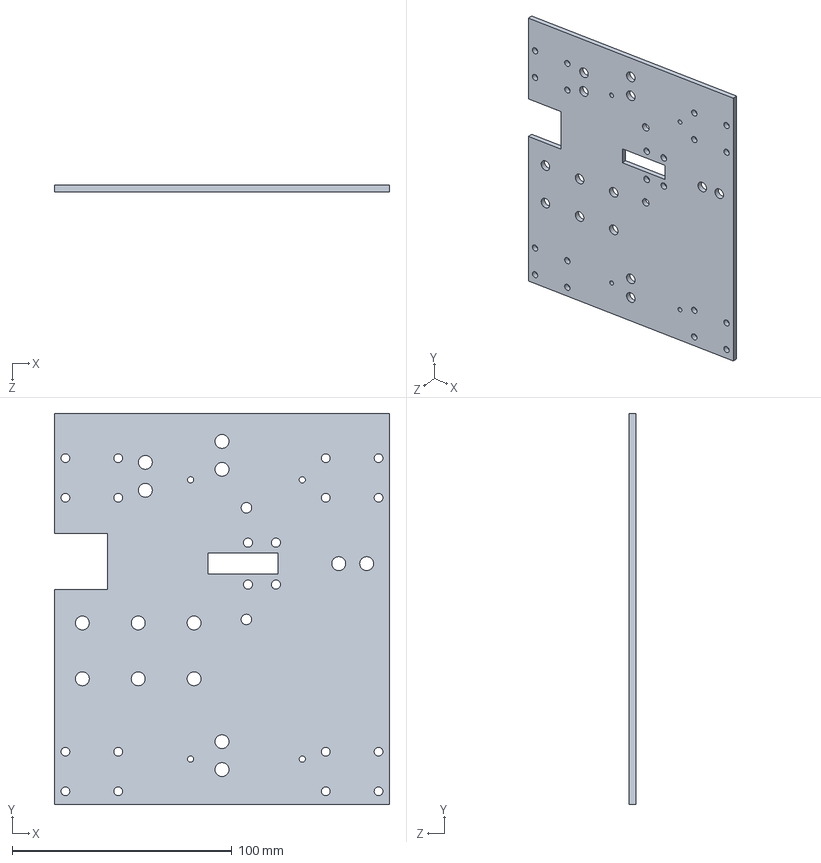
[picture p121: CAD file, 2015-03-23]
portfolio/Documents/CAD/flux-wire asm/flux-wire rails base.SLDPRT
152.4 x 177.8 x 3.17 mm
