enewhall/Mechatronics/portfolio/Documents/CAD/Revolver_Subassembly/Revolver_motor_plate.SLDPRT

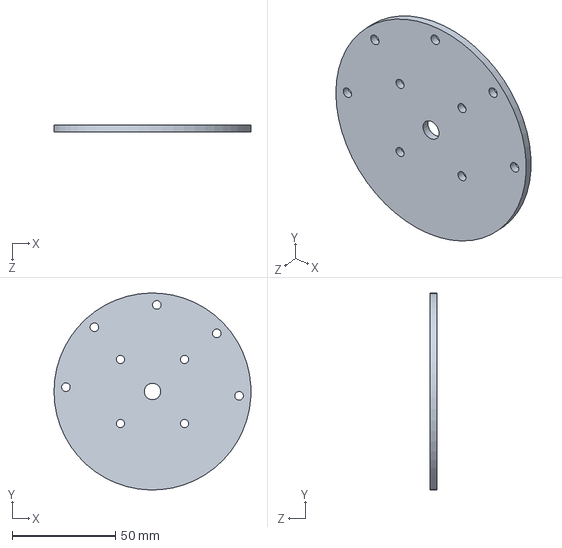
[picture p122: CAD file, 2015-03-23]
portfolio/Documents/CAD/Revolver_Subassembly/Revolver_motor_plate.SLDPRT
95.2 x 95.2 x 3.17 mm
