enewhall/Mechatronics/portfolio/Documents/CAD/8020 frame/corner bracket.SLDPRT

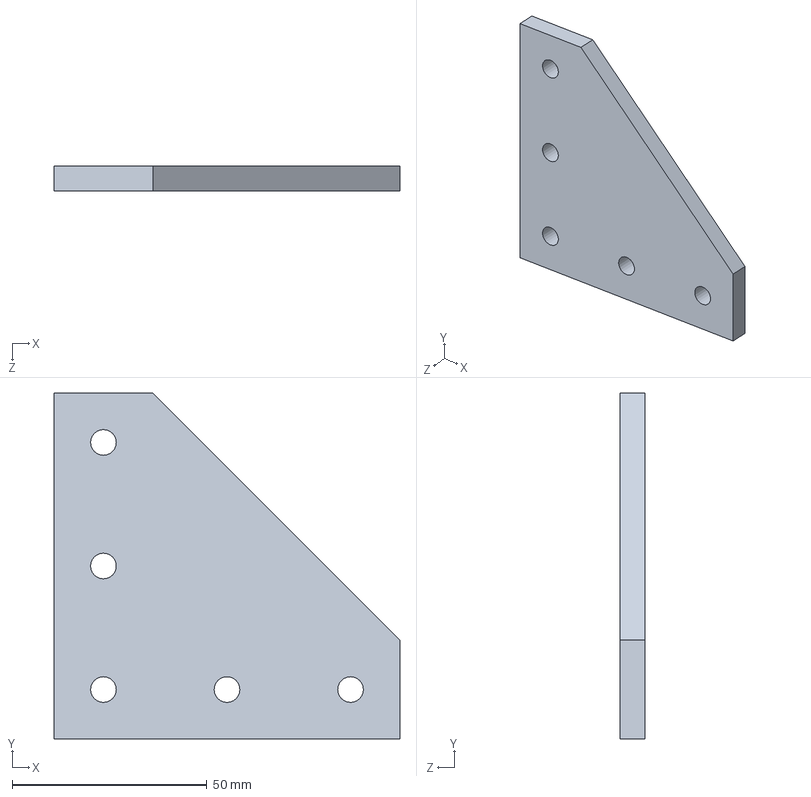
[picture p124: CAD file, 2015-03-01]
portfolio/Documents/CAD/8020 frame/corner bracket.SLDPRT
88.9 x 88.9 x 6.35 mm
