enewhall/Mechatronics/portfolio/Documents/CAD/base asm/bottom plate.SLDPRT

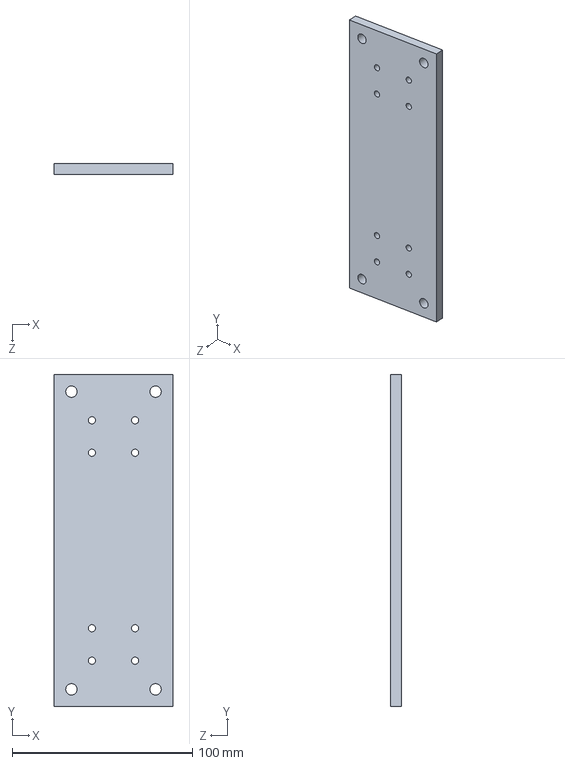
[picture p125: CAD file, 2015-03-01]
portfolio/Documents/CAD/base asm/bottom plate.SLDPRT
65.8 x 184.1 x 5.99 mm
