enewhall/Mechatronics/portfolio/Documents/CAD/part placer asm/rack.SLDPRT

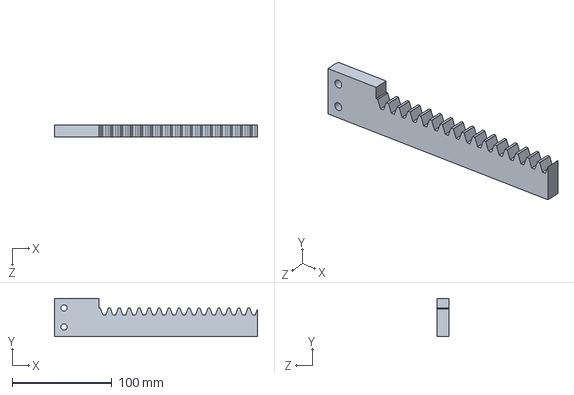
[picture p126: CAD file, 2015-03-21]
portfolio/Documents/CAD/part placer asm/rack.SLDPRT
203.2 x 38.1 x 11.8 mm
