enewhall/Mechatronics/portfolio/Documents/CAD/pinion.SLDPRT

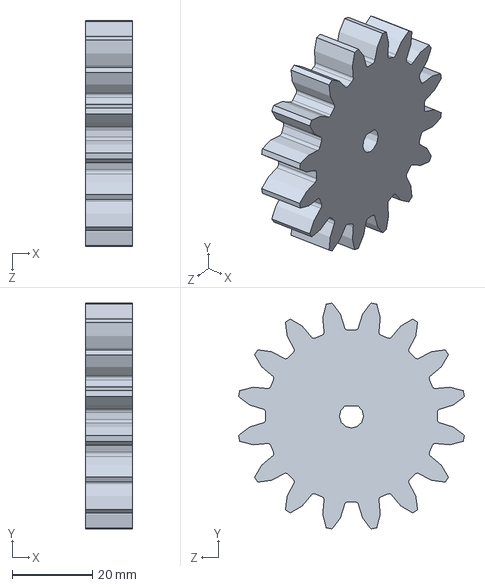
[picture p127: CAD file, 2015-03-21]
portfolio/Documents/CAD/pinion.SLDPRT
11.8 x 56.3 x 56.3 mm
