enewhall/Mechatronics/portfolio/Documents/CAD/Revolver_Subassembly/Revolver_45deg.SLDPRT

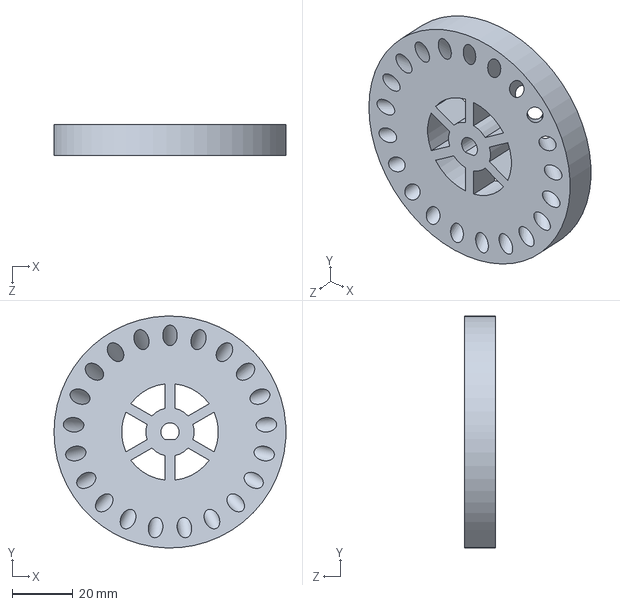
[picture p128: CAD file, 2015-03-23]
portfolio/Documents/CAD/Revolver_Subassembly/Revolver_45deg.SLDPRT
76.2 x 76.2 x 10.2 mm
