enewhall/Mechatronics/portfolio/Documents/CAD/wire cutter/wire cutter attachemetn.DXF

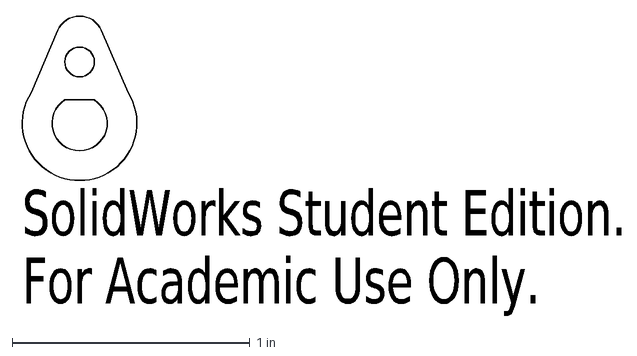
[picture p129: CAD file, 2015-04-01]
portfolio/Documents/CAD/wire cutter/wire cutter attachemetn.DXF
SolidWorks Student Edition.
For Academic Use Only.
