enewhall/Mechatronics/portfolio/Documents/CAD/8020 frame/8020-18in.SLDPRT

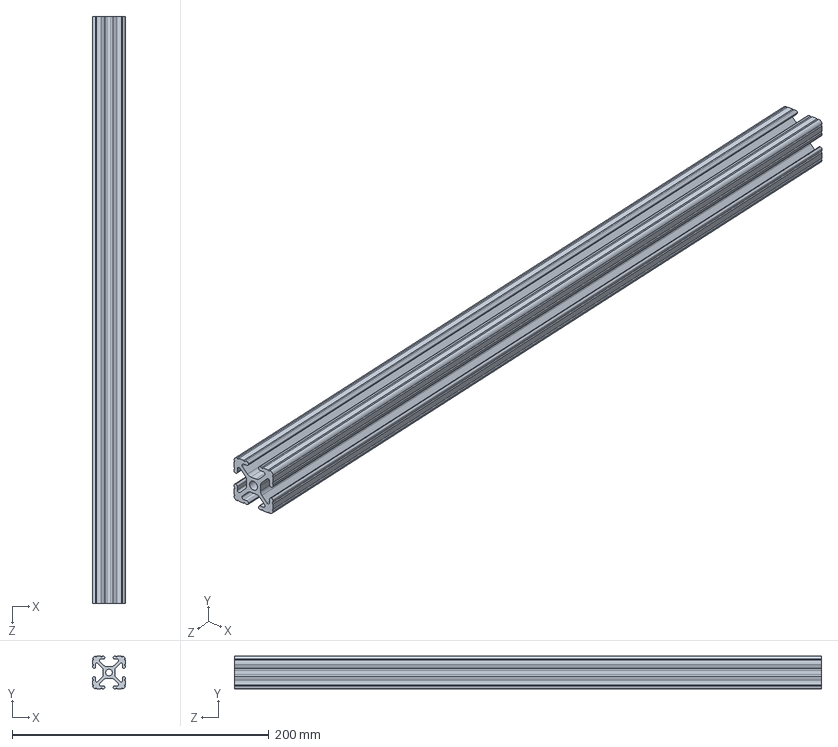
[picture p130: CAD file, 2015-03-01]
portfolio/Documents/CAD/8020 frame/8020-18in.SLDPRT
25.4 x 25.4 x 457.2 mm
