enewhall/Mechatronics/portfolio/Documents/CAD/base asm/middle plate.SLDPRT

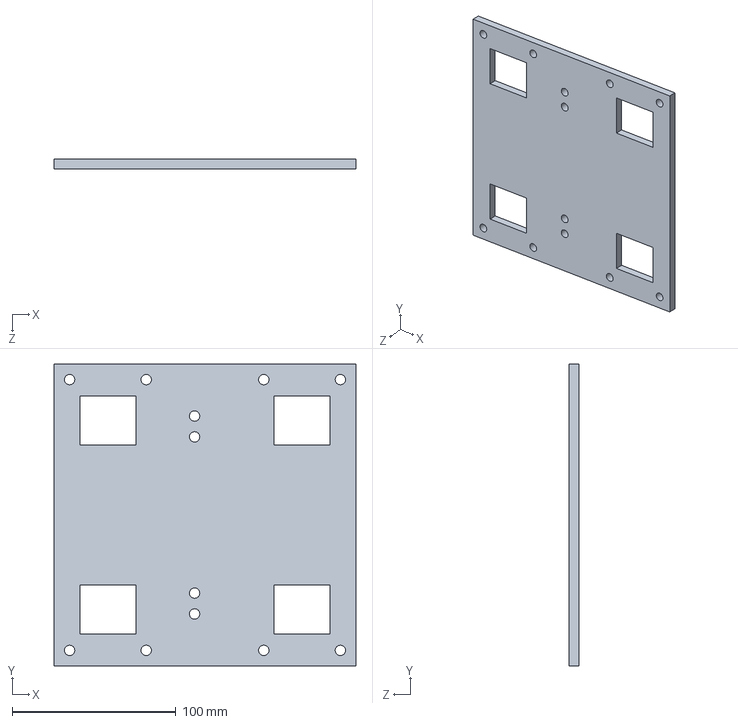
[picture p131: CAD file, 2015-03-01]
portfolio/Documents/CAD/base asm/middle plate.SLDPRT
184.1 x 184.1 x 5.99 mm
