enewhall/Mechatronics/portfolio/Documents/CAD/bottom rails asm/8mm rod.SLDPRT

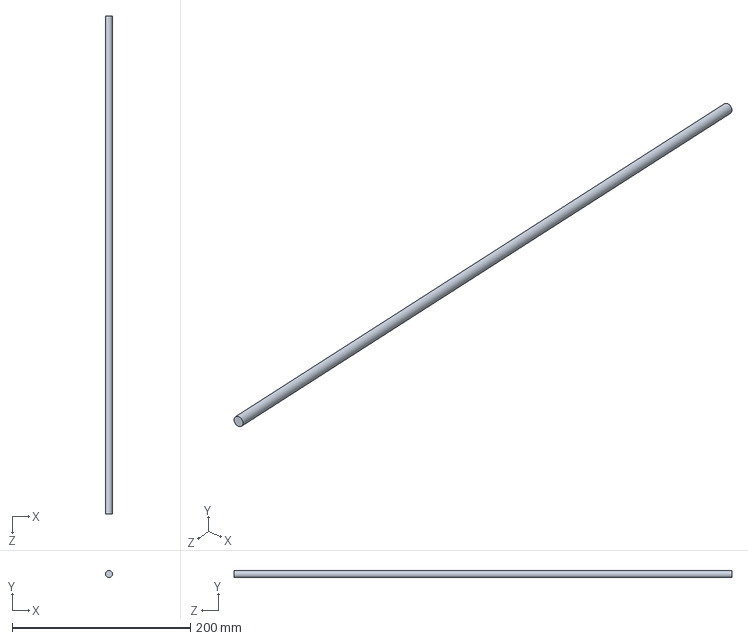
[picture p132: CAD file, 2015-03-01]
portfolio/Documents/CAD/bottom rails asm/8mm rod.SLDPRT
8.00 x 8.00 x 558.8 mm
