enewhall/Mechatronics/portfolio/Documents/CAD/flux-wire asm/bottom plate.SLDPRT

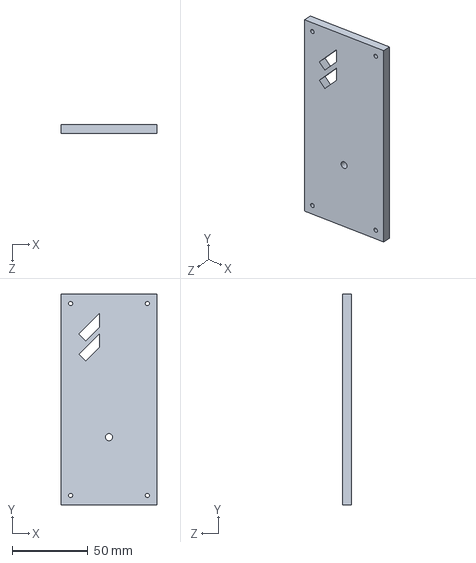
[picture p133: CAD file, 2015-03-21]
portfolio/Documents/CAD/flux-wire asm/bottom plate.SLDPRT
63.5 x 139.7 x 5.99 mm
