enewhall/Mechatronics/portfolio/Documents/CAD/l-bracket gearmotor wire cutter.SLDPRT

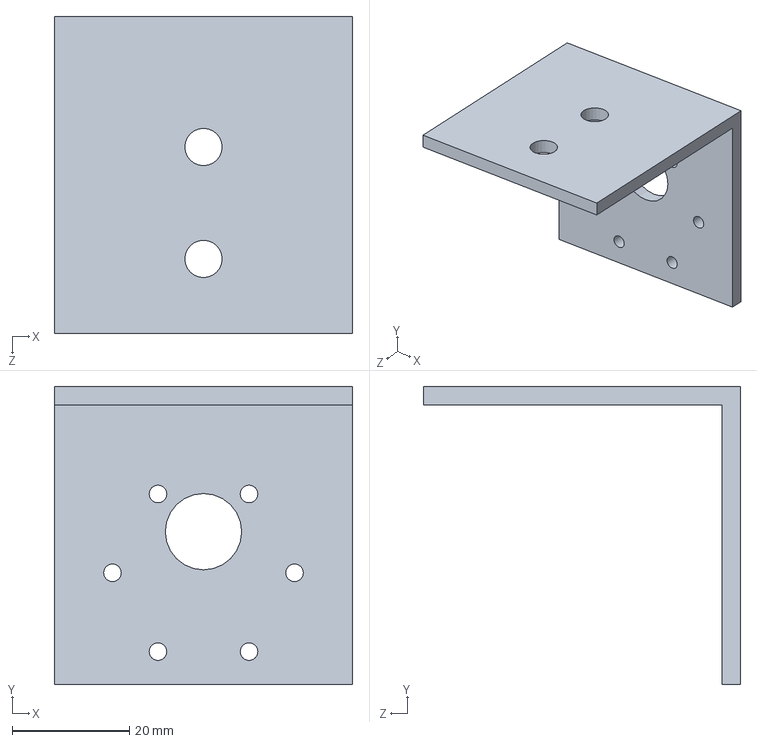
[picture p134: CAD file, 2015-03-21]
portfolio/Documents/CAD/l-bracket gearmotor wire cutter.SLDPRT
50.8 x 50.8 x 54.0 mm
