enewhall/Mechatronics/portfolio/Documents/CAD/part placer asm/front motor plate.SLDPRT

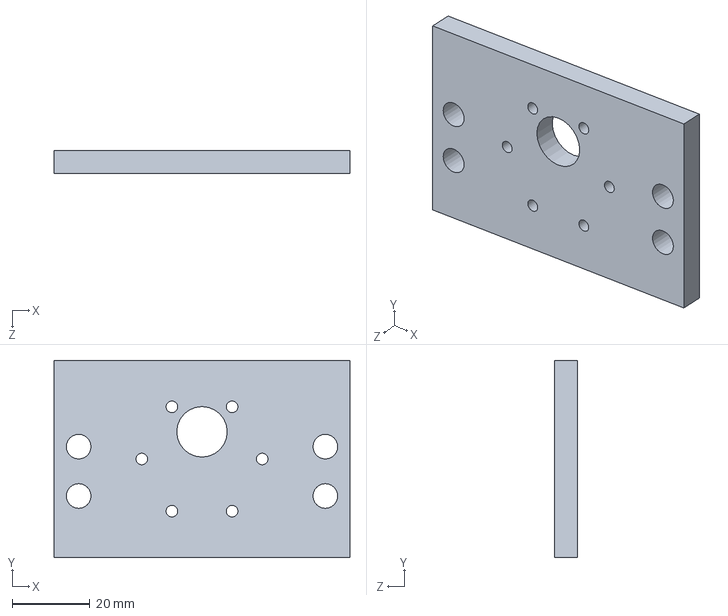
[picture p135: CAD file, 2015-03-21]
portfolio/Documents/CAD/part placer asm/front motor plate.SLDPRT
76.2 x 50.8 x 5.99 mm
