enewhall/Mechatronics/portfolio/Documents/CAD/Revolver_Subassembly/Revolver_motor_plate2.SLDPRT

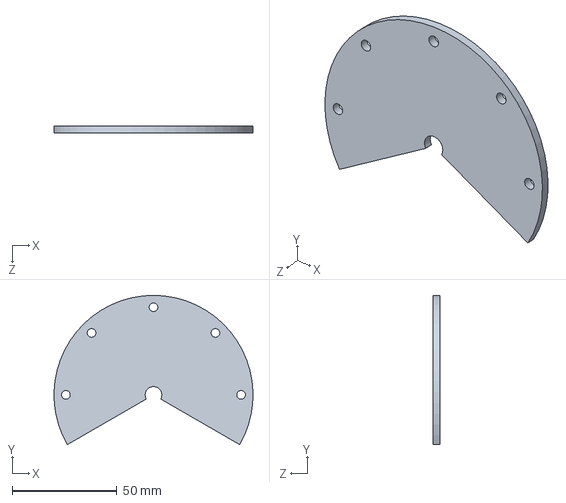
[picture p136: CAD file, 2015-03-23]
portfolio/Documents/CAD/Revolver_Subassembly/Revolver_motor_plate2.SLDPRT
95.2 x 71.4 x 3.17 mm
