enewhall/Mechatronics/portfolio/Documents/CAD/wire cutter/vertical shit.DXF

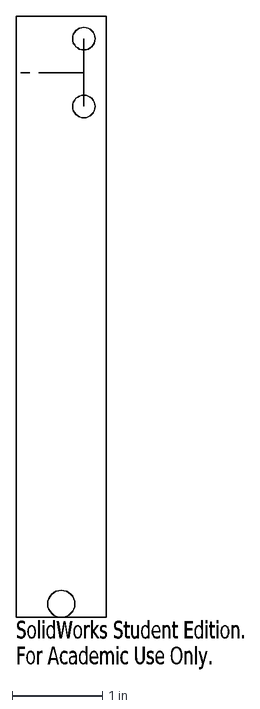
[picture p137: CAD file, 2015-04-01]
portfolio/Documents/CAD/wire cutter/vertical shit.DXF
SolidWorks Student Edition.
For Academic Use Only.
