enewhall/Mechatronics/portfolio/Documents/CAD/8020 frame/8020-12in.SLDPRT

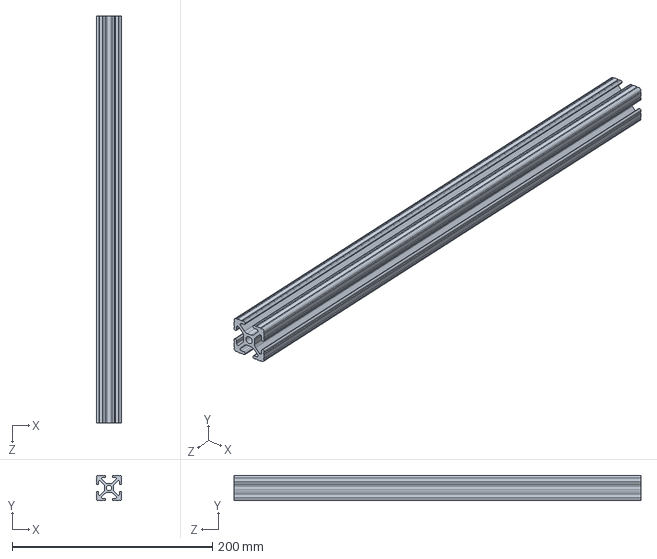
[picture p138: CAD file, 2015-03-01]
portfolio/Documents/CAD/8020 frame/8020-12in.SLDPRT
25.4 x 25.4 x 406.4 mm
