enewhall/Mechatronics/portfolio/Documents/CAD/bottom rails asm/L-bracket belt mount.SLDPRT

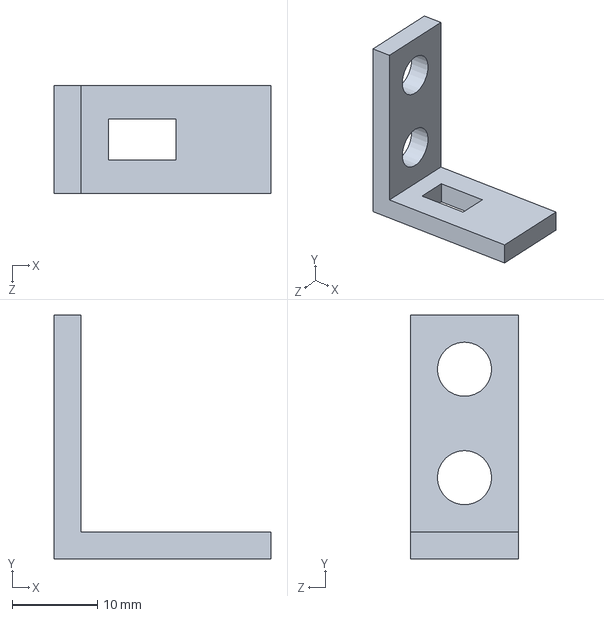
[picture p139: CAD file, 2015-03-01]
portfolio/Documents/CAD/bottom rails asm/L-bracket belt mount.SLDPRT
25.4 x 28.6 x 12.7 mm
