enewhall/Mechatronics/portfolio/Documents/CAD/flux-wire asm/syringe.SLDPRT

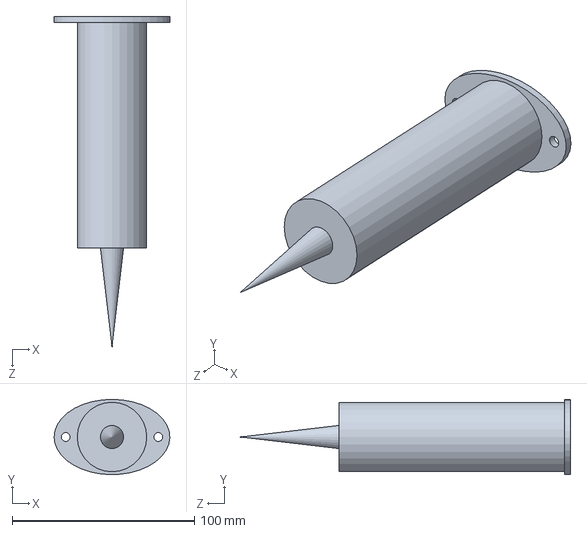
[picture p140: CAD file, 2015-03-21]
portfolio/Documents/CAD/flux-wire asm/syringe.SLDPRT
63.5 x 41.3 x 181.0 mm
