enewhall/Mechatronics/portfolio/Documents/CAD/part placer asm/servo mounting brackets.SLDPRT

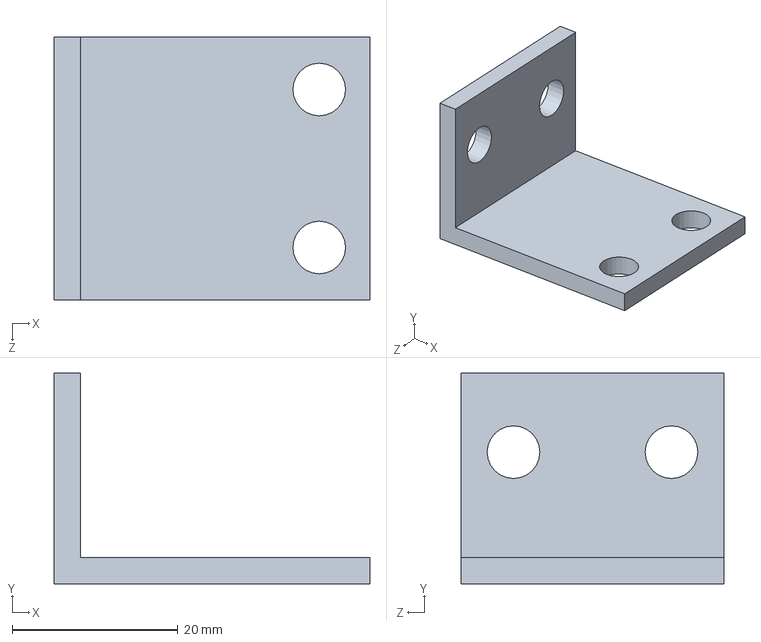
[picture p141: CAD file, 2015-03-01]
portfolio/Documents/CAD/part placer asm/servo mounting brackets.SLDPRT
38.1 x 25.4 x 31.8 mm
