enewhall/Mechatronics/portfolio/Documents/CAD/wire cutter/wire feeder piece.DXF

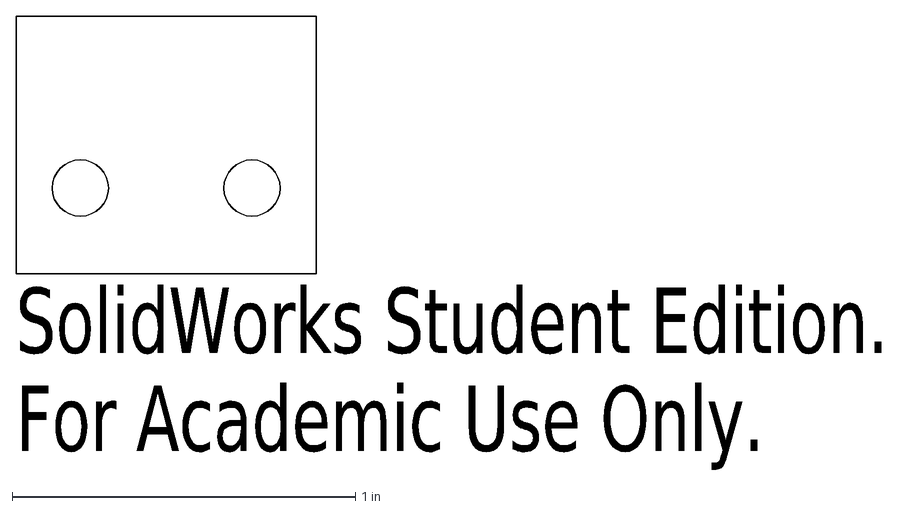
[picture p142: CAD file, 2015-04-01]
portfolio/Documents/CAD/wire cutter/wire feeder piece.DXF
SolidWorks Student Edition.
For Academic Use Only.
