enewhall/Mechatronics/portfolio/Documents/CAD/8020 frame/8020-20in.SLDPRT

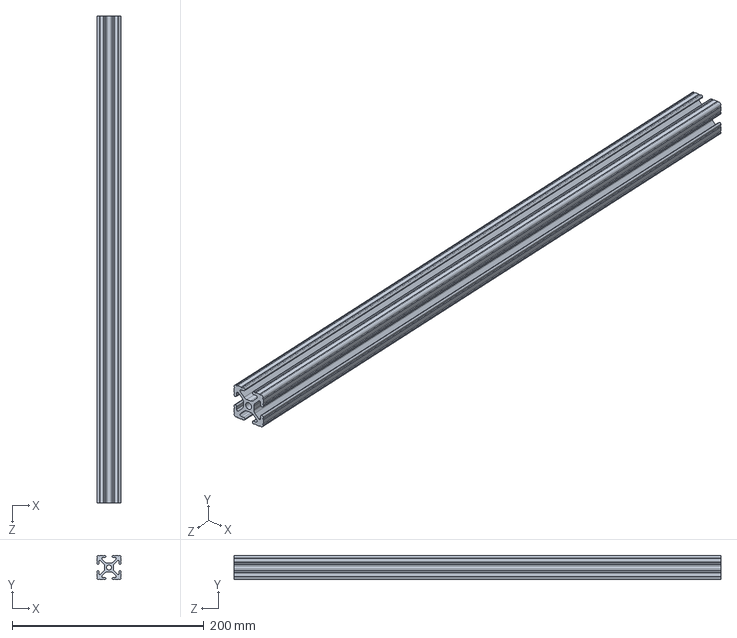
[picture p143: CAD file, 2015-03-01]
portfolio/Documents/CAD/8020 frame/8020-20in.SLDPRT
25.4 x 25.4 x 508.0 mm
