enewhall/Mechatronics/portfolio/Documents/CAD/bottom rails asm/Linear Rail Shaft Guide.SLDPRT

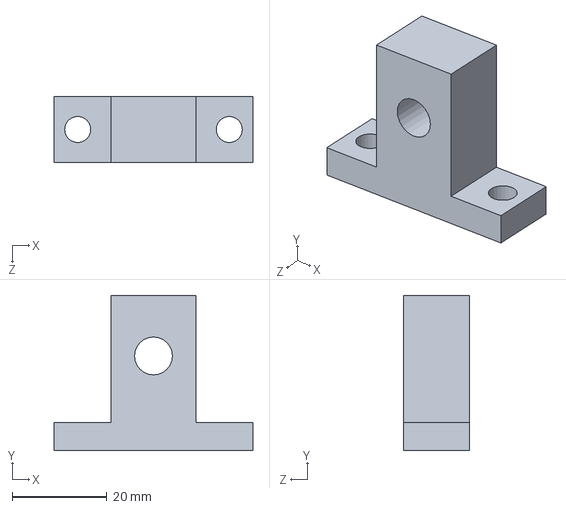
[picture p144: CAD file, 2015-03-01]
portfolio/Documents/CAD/bottom rails asm/Linear Rail Shaft Guide.SLDPRT
42.0 x 32.8 x 14.0 mm
