enewhall/Mechatronics/portfolio/Documents/CAD/flux-wire asm/flux rack.SLDPRT

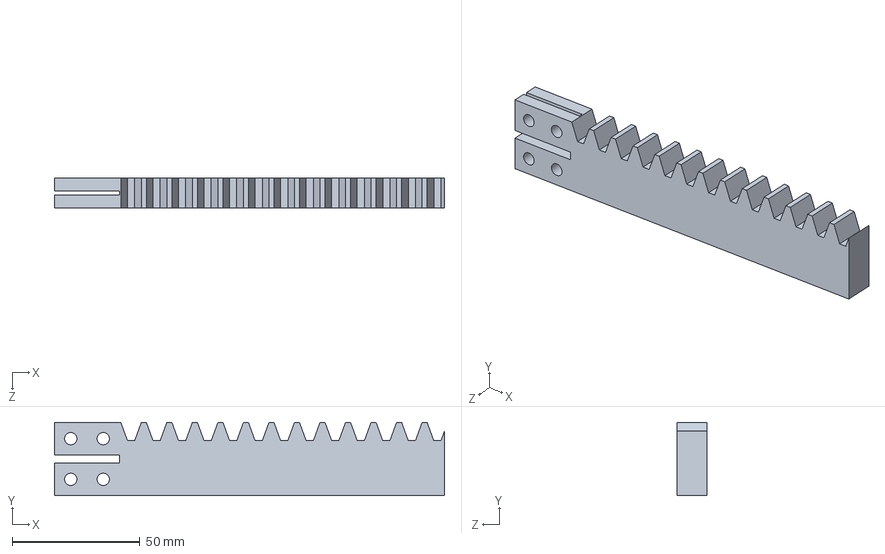
[picture p145: CAD file, 2015-03-21]
portfolio/Documents/CAD/flux-wire asm/flux rack.SLDPRT
152.4 x 28.6 x 11.8 mm
