enewhall/Mechatronics/portfolio/Documents/CAD/part placer asm/servo mount.SLDPRT

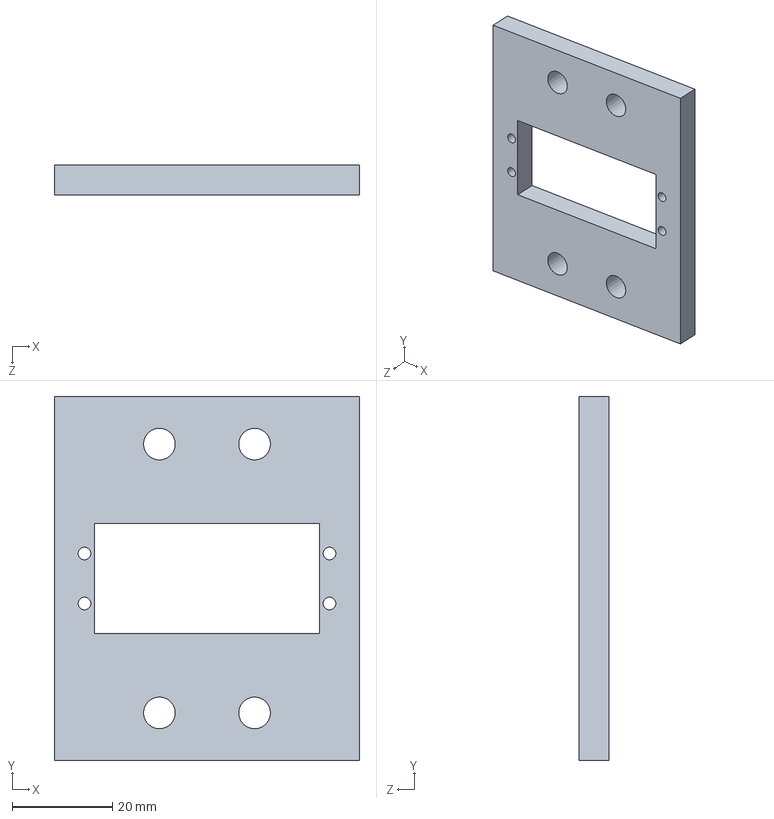
[picture p146: CAD file, 2015-03-01]
portfolio/Documents/CAD/part placer asm/servo mount.SLDPRT
61.0 x 72.8 x 5.99 mm
