enewhall/Mechatronics/portfolio/Documents/CAD/Revolver_Subassembly/l-bracket gearmotor revolver.SLDPRT

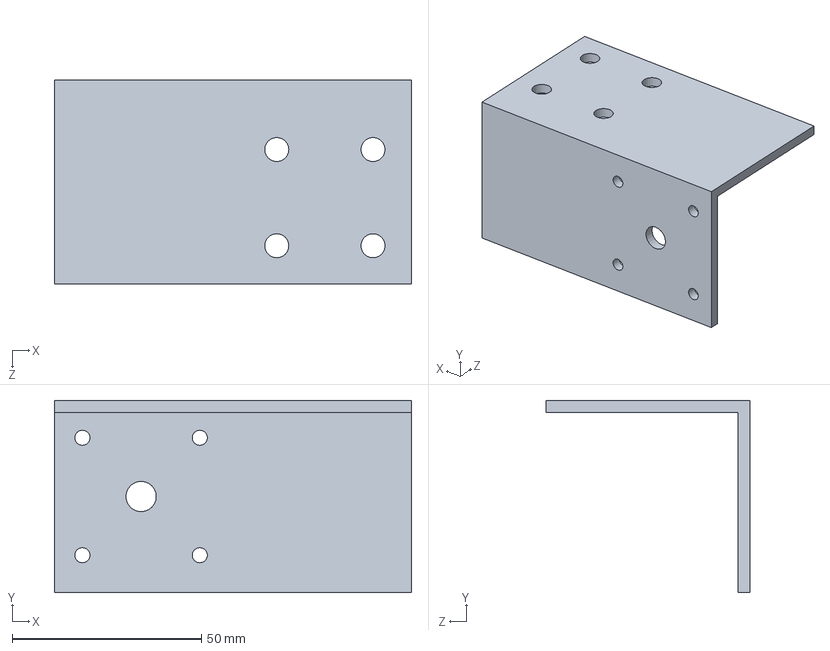
[picture p147: CAD file, 2015-03-23]
portfolio/Documents/CAD/Revolver_Subassembly/l-bracket gearmotor revolver.SLDPRT
94.2 x 50.8 x 54.0 mm
