enewhall/Mechatronics/portfolio/Documents/CAD/wire cutter/feeder pulley 1-16.DXF

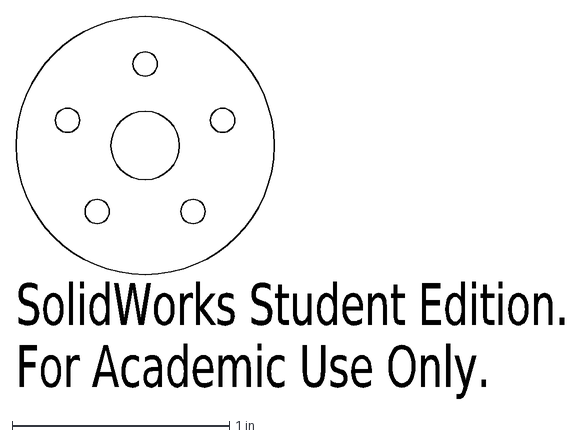
[picture p148: CAD file, 2015-04-01]
portfolio/Documents/CAD/wire cutter/feeder pulley 1-16.DXF
SolidWorks Student Edition.
For Academic Use Only.
