enewhall/Mechatronics/portfolio/Documents/CAD/Black_box_wire_cutter.SLDPRT

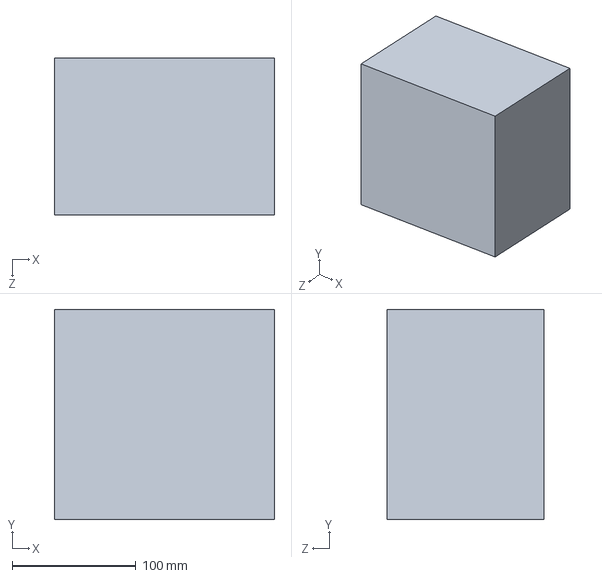
[picture p149: CAD file, 2015-03-02]
portfolio/Documents/CAD/Black_box_wire_cutter.SLDPRT
177.8 x 170.0 x 127.0 mm
