enewhall/Mechatronics/portfolio/Documents/CAD/bottom rails asm/L-bracket idler mount.SLDPRT

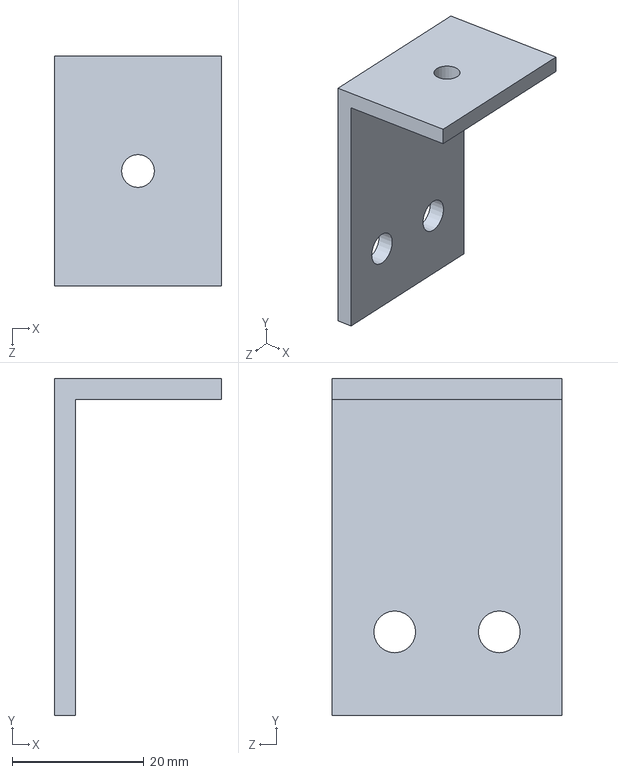
[picture p150: CAD file, 2015-03-01]
portfolio/Documents/CAD/bottom rails asm/L-bracket idler mount.SLDPRT
25.4 x 51.2 x 34.9 mm
