enewhall/Mechatronics/portfolio/Documents/CAD/flux-wire asm/wire cutter servo mount.SLDPRT

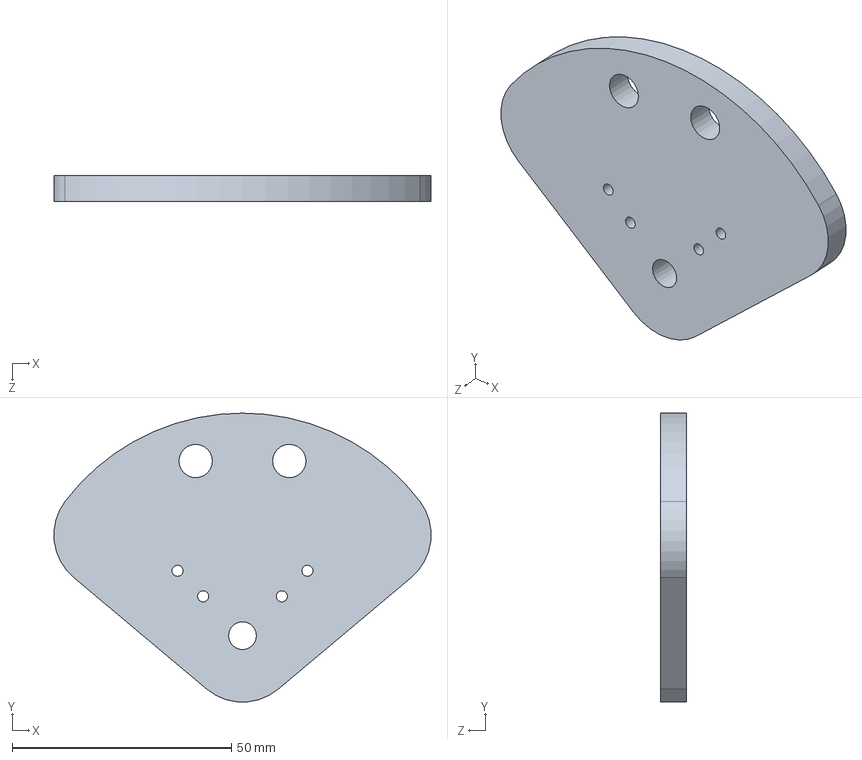
[picture p151: CAD file, 2015-03-21]
portfolio/Documents/CAD/flux-wire asm/wire cutter servo mount.SLDPRT
86.1 x 65.9 x 5.99 mm
