enewhall/Mechatronics/portfolio/Documents/CAD/part placer asm/gearmotor mounting brackets.SLDPRT

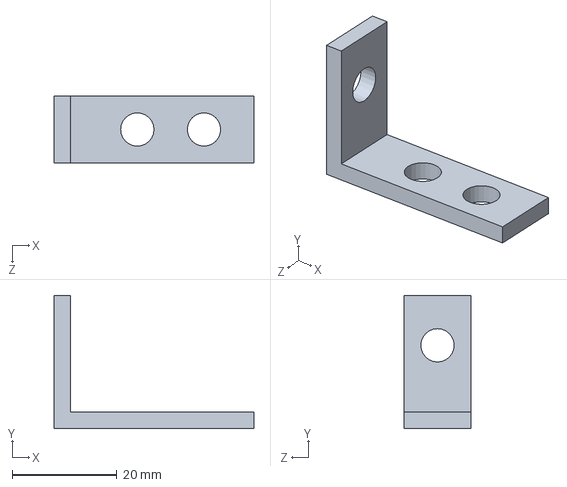
[picture p152: CAD file, 2015-03-01]
portfolio/Documents/CAD/part placer asm/gearmotor mounting brackets.SLDPRT
38.1 x 25.4 x 12.7 mm
