enewhall/Mechatronics/portfolio/Documents/CAD/wire cutter/gearmotor gear.SLDPRT

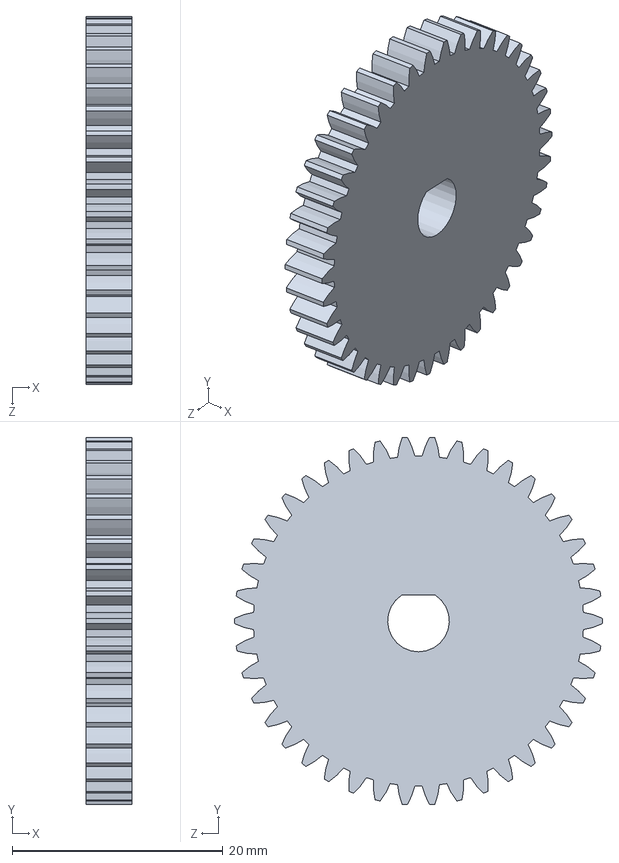
[picture p153: CAD file, 2015-04-01]
portfolio/Documents/CAD/wire cutter/gearmotor gear.SLDPRT
4.39 x 34.9 x 34.9 mm
