enewhall/Mechatronics/portfolio/Documents/CAD/bottom rails asm/L-bracket motor mount.SLDPRT

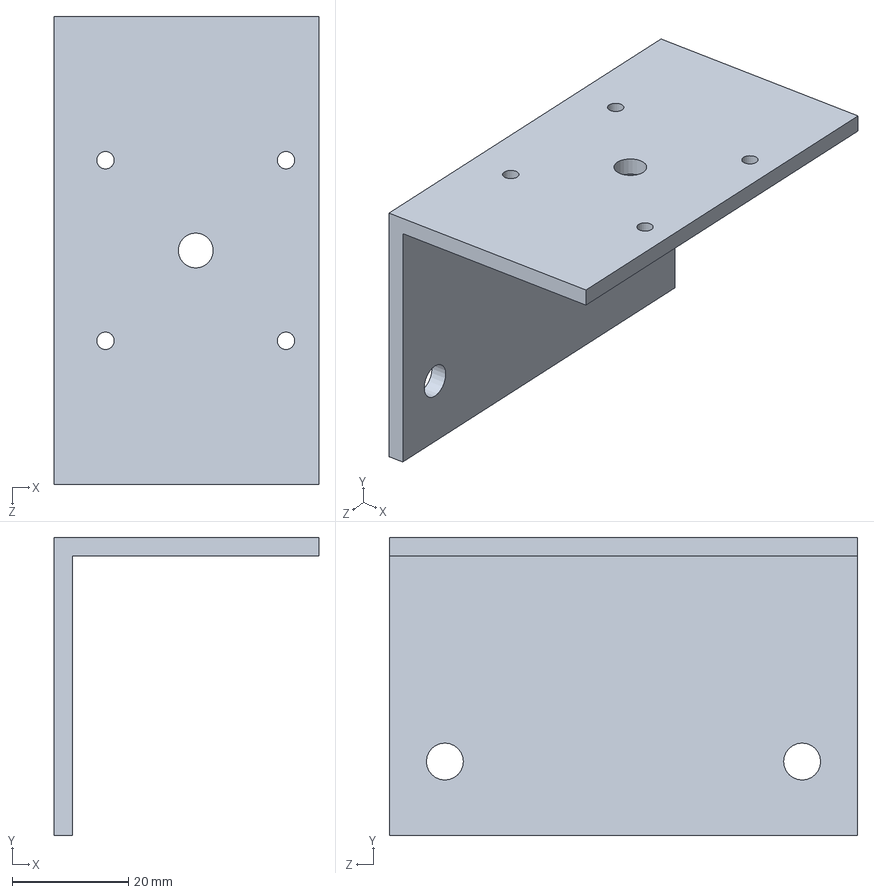
[picture p154: CAD file, 2015-03-01]
portfolio/Documents/CAD/bottom rails asm/L-bracket motor mount.SLDPRT
45.5 x 51.2 x 80.4 mm
