enewhall/Mechatronics/portfolio/Documents/CAD/part placer asm/rack left plate.SLDPRT

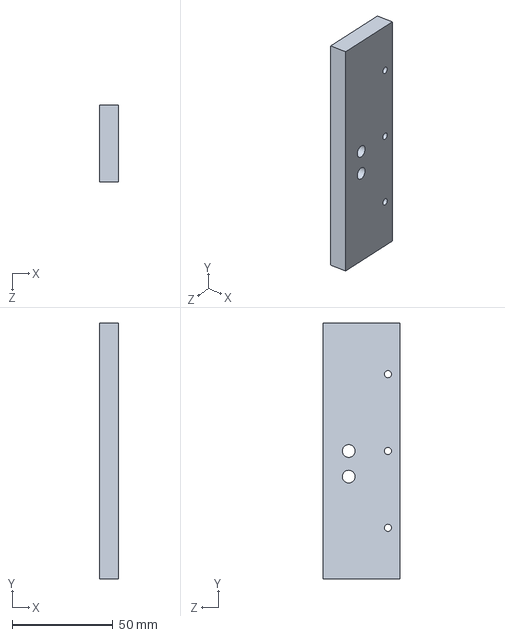
[picture p155: CAD file, 2015-03-01]
portfolio/Documents/CAD/part placer asm/rack left plate.SLDPRT
9.53 x 127.0 x 38.1 mm
