enewhall/Mechatronics/portfolio/Documents/CAD/Revolver_Subassembly/Revolver_motor_plate_middle.SLDPRT

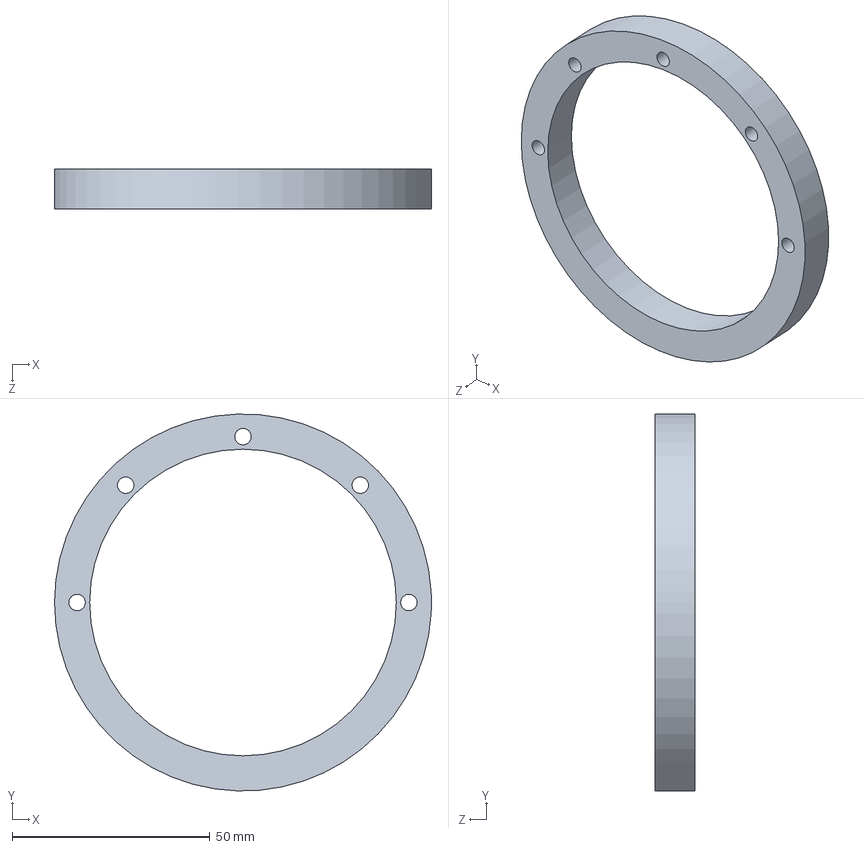
[picture p156: CAD file, 2015-03-23]
portfolio/Documents/CAD/Revolver_Subassembly/Revolver_motor_plate_middle.SLDPRT
95.2 x 95.2 x 10.2 mm
