enewhall/Mechatronics/portfolio/Documents/CAD/stepper motor.SLDPRT

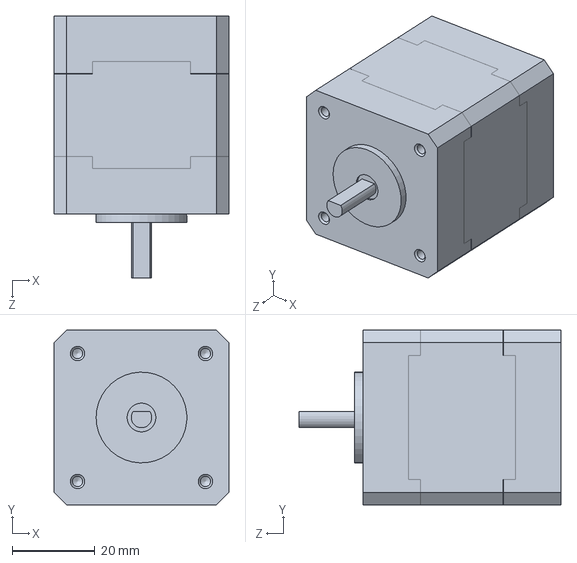
[picture p157: CAD file, 2015-03-01]
portfolio/Documents/CAD/stepper motor.SLDPRT
42.3 x 42.3 x 63.5 mm
