enewhall/Mechatronics/portfolio/Documents/CAD/wire cutter/wire feeder shaft aligner plate.SLDPRT

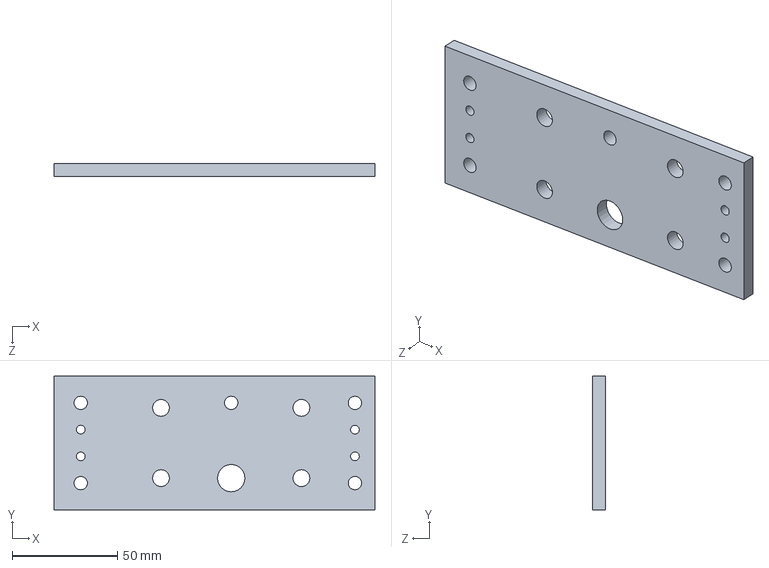
[picture p158: CAD file, 2015-04-01]
portfolio/Documents/CAD/wire cutter/wire feeder shaft aligner plate.SLDPRT
152.4 x 63.5 x 5.99 mm
