enewhall/Mechatronics/portfolio/Documents/CAD/flux-wire asm/rack side plates.SLDPRT

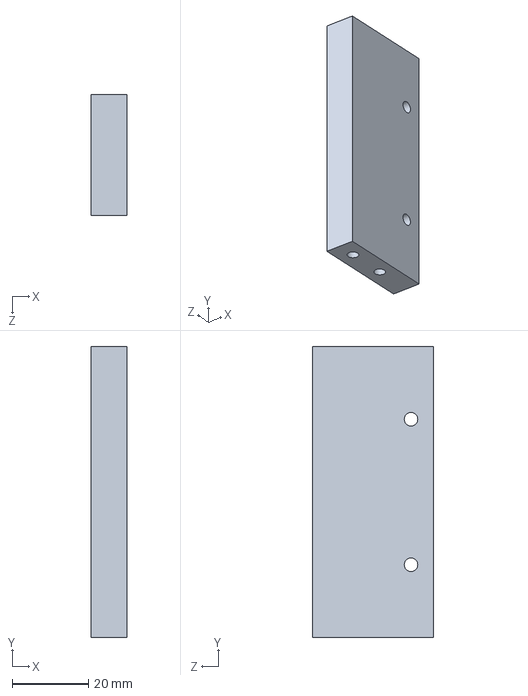
[picture p159: CAD file, 2015-03-21]
portfolio/Documents/CAD/flux-wire asm/rack side plates.SLDPRT
9.53 x 76.2 x 31.8 mm
