enewhall/Mechatronics/portfolio/Documents/CAD/part placer asm/servo.SLDPRT

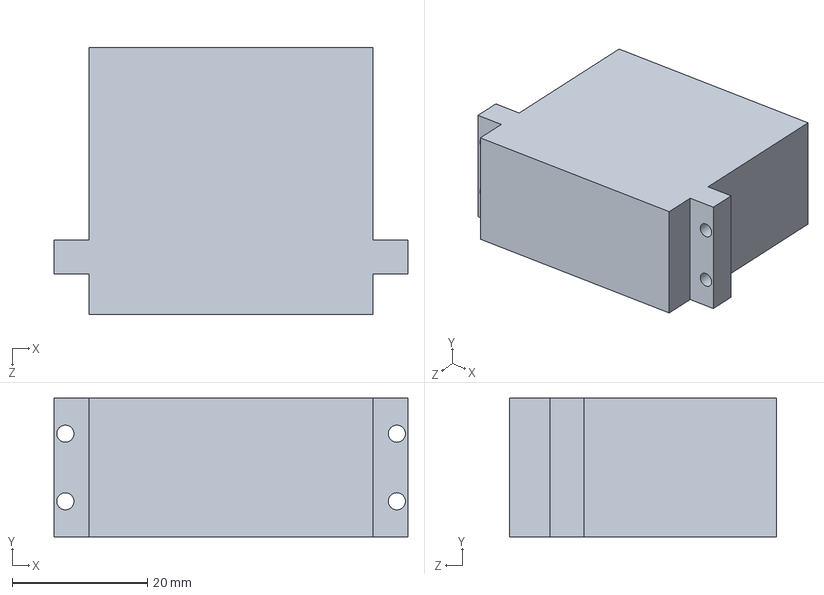
[picture p160: CAD file, 2015-03-01]
portfolio/Documents/CAD/part placer asm/servo.SLDPRT
52.3 x 20.5 x 39.5 mm
