enewhall/Mechatronics/portfolio/Documents/CAD/wire cutter/Part2.DXF

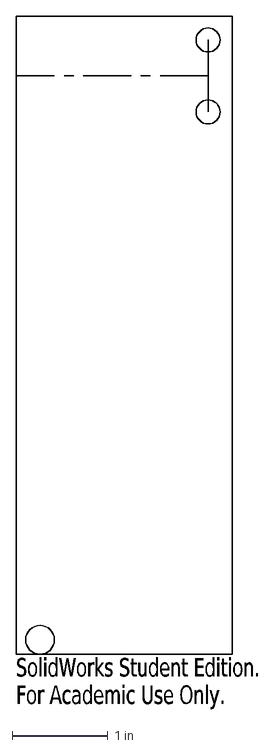
[picture p161: CAD file, 2015-04-01]
portfolio/Documents/CAD/wire cutter/Part2.DXF
SolidWorks Student Edition.
For Academic Use Only.
