enewhall/Mechatronics/portfolio/Documents/CAD/flux-wire asm/wire tube servo mount.SLDPRT

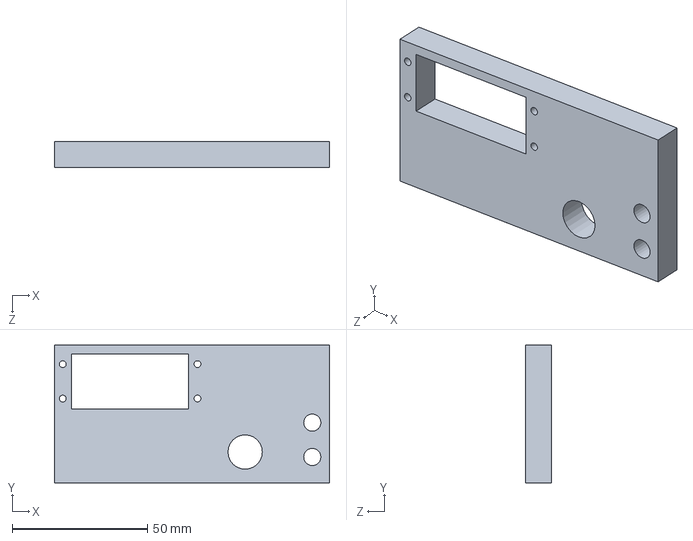
[picture p162: CAD file, 2015-03-21]
portfolio/Documents/CAD/flux-wire asm/wire tube servo mount.SLDPRT
101.6 x 50.8 x 9.53 mm
