enewhall/Mechatronics/portfolio/Documents/CAD/L-bracket motor mount-part placer.SLDPRT

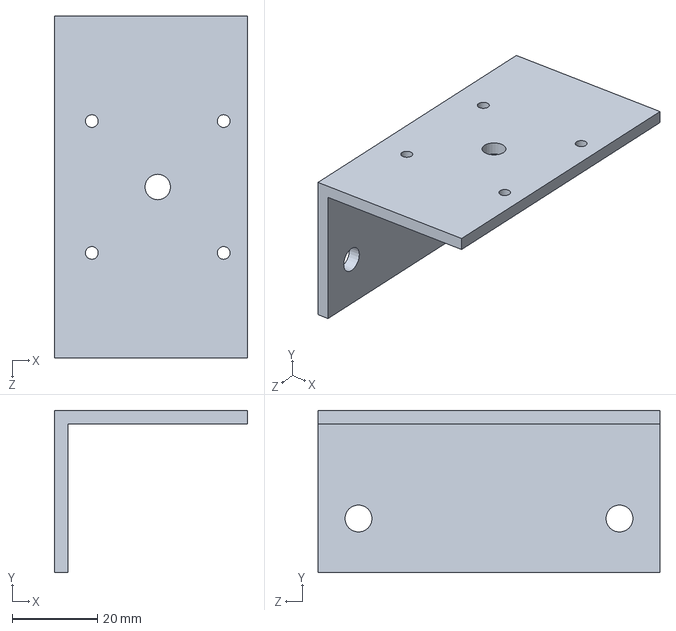
[picture p163: CAD file, 2015-03-01]
portfolio/Documents/CAD/L-bracket motor mount-part placer.SLDPRT
45.5 x 38.1 x 80.4 mm
