enewhall/Mechatronics/portfolio/Documents/CAD/part placer asm/rack back plate.SLDPRT

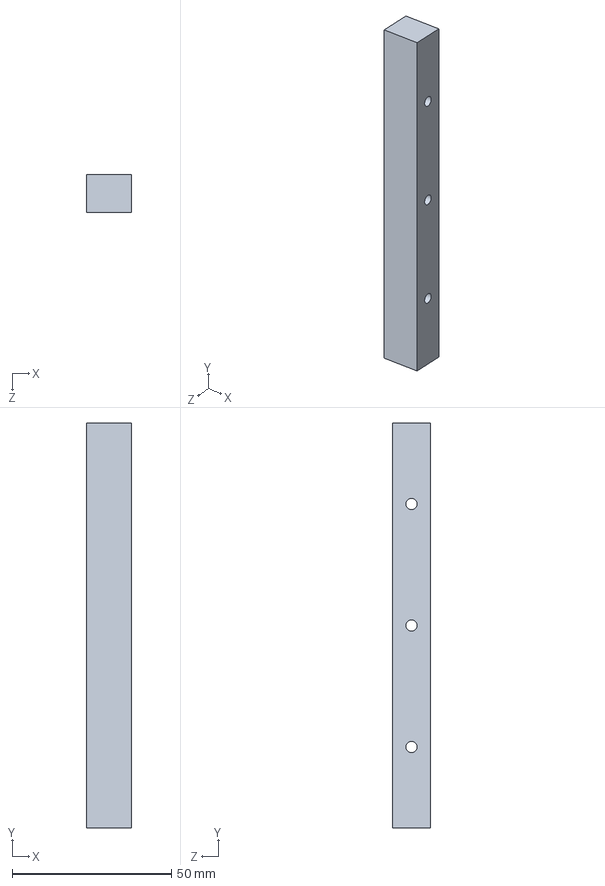
[picture p164: CAD file, 2015-03-01]
portfolio/Documents/CAD/part placer asm/rack back plate.SLDPRT
14.0 x 127.0 x 11.8 mm
