enewhall/Mechatronics/portfolio/Documents/CAD/wire cutter/feeder spacer guide.DXF

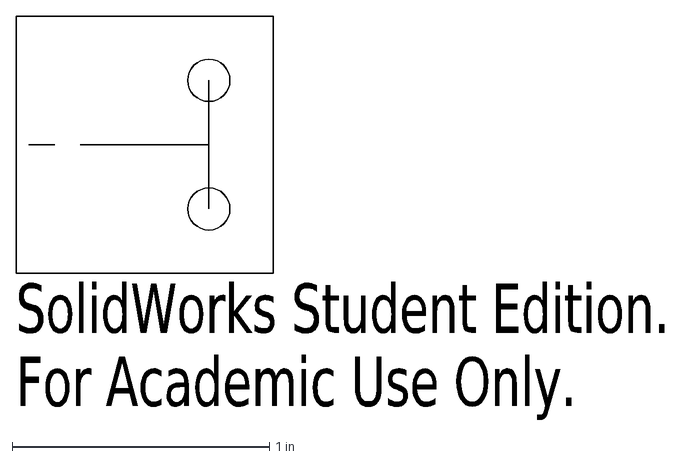
[picture p165: CAD file, 2015-04-01]
portfolio/Documents/CAD/wire cutter/feeder spacer guide.DXF
SolidWorks Student Edition.
For Academic Use Only.
