enewhall/Mechatronics/portfolio/Documents/CAD/flux-wire asm/rack back plate - flux.SLDPRT

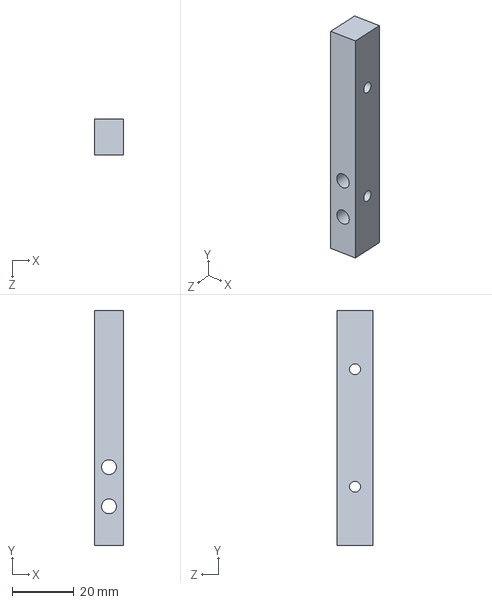
[picture p166: CAD file, 2015-03-21]
portfolio/Documents/CAD/flux-wire asm/rack back plate - flux.SLDPRT
9.53 x 76.2 x 11.8 mm
