enewhall/Mechatronics/portfolio/Documents/CAD/L-bracket idler mount-part placer.SLDPRT

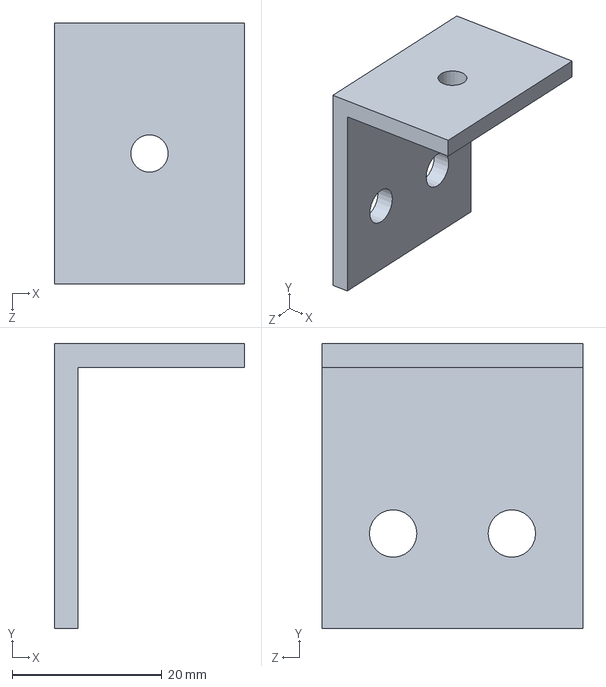
[picture p167: CAD file, 2015-03-01]
portfolio/Documents/CAD/L-bracket idler mount-part placer.SLDPRT
25.4 x 38.1 x 34.9 mm
