enewhall/Mechatronics/portfolio/Documents/CAD/part placer asm/mounting plate.SLDPRT

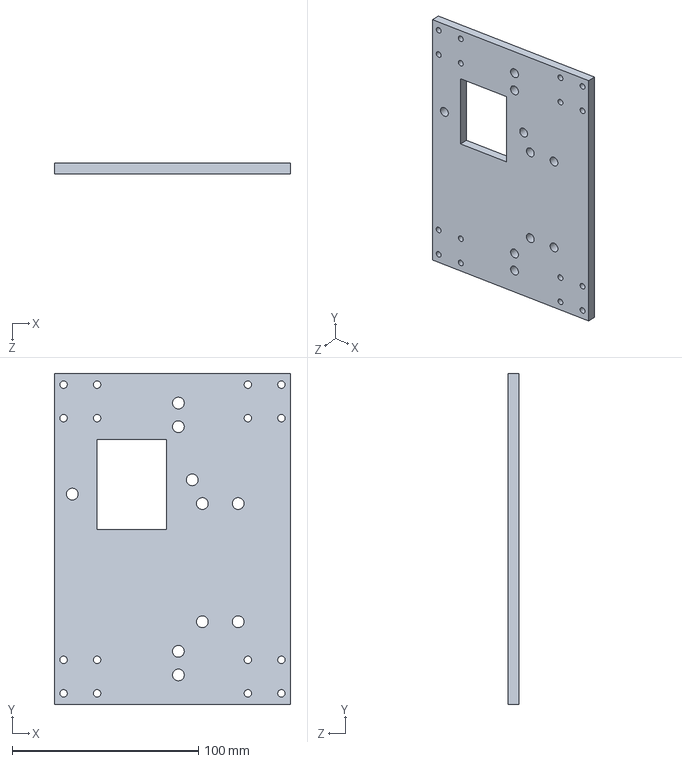
[picture p168: CAD file, 2015-03-01]
portfolio/Documents/CAD/part placer asm/mounting plate.SLDPRT
127.0 x 177.8 x 5.99 mm
