enewhall/Mechatronics/portfolio/Documents/CAD/wire cutter/Part3.DXF

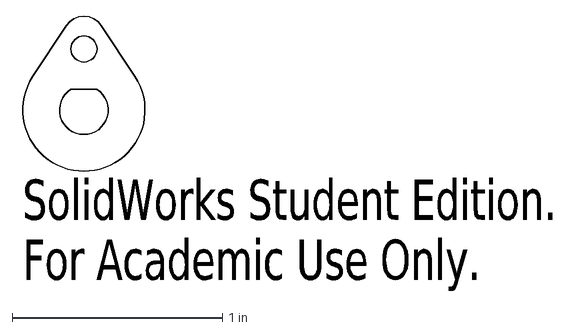
[picture p169: CAD file, 2015-04-01]
portfolio/Documents/CAD/wire cutter/Part3.DXF
SolidWorks Student Edition.
For Academic Use Only.
