enewhall/Mechatronics/portfolio/Documents/CAD/flux-wire asm/gearmotor pinion.SLDPRT

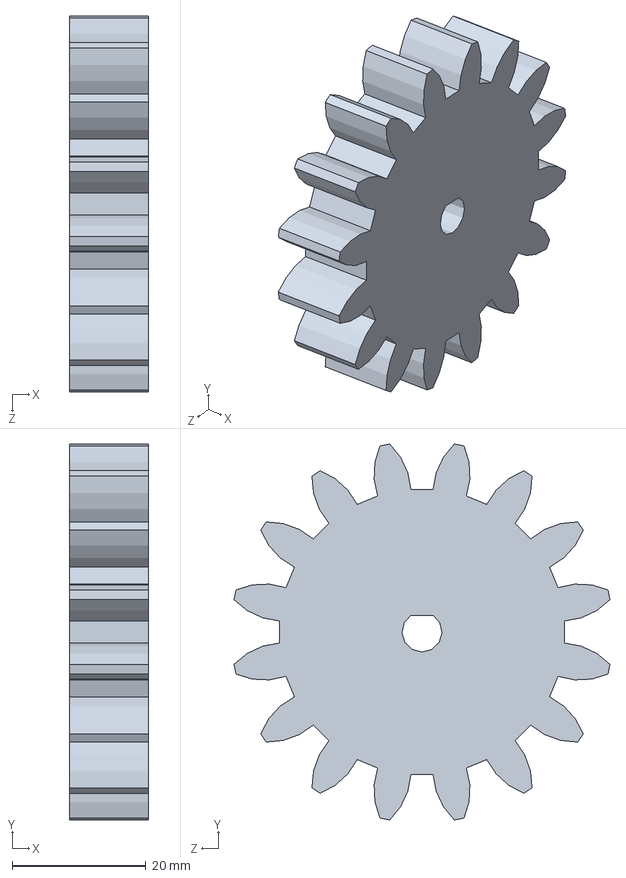
[picture p170: CAD file, 2015-03-21]
portfolio/Documents/CAD/flux-wire asm/gearmotor pinion.SLDPRT
11.8 x 56.3 x 56.3 mm
