enewhall/Mechatronics/portfolio/Documents/CAD/part placer asm/rack right plate.SLDPRT

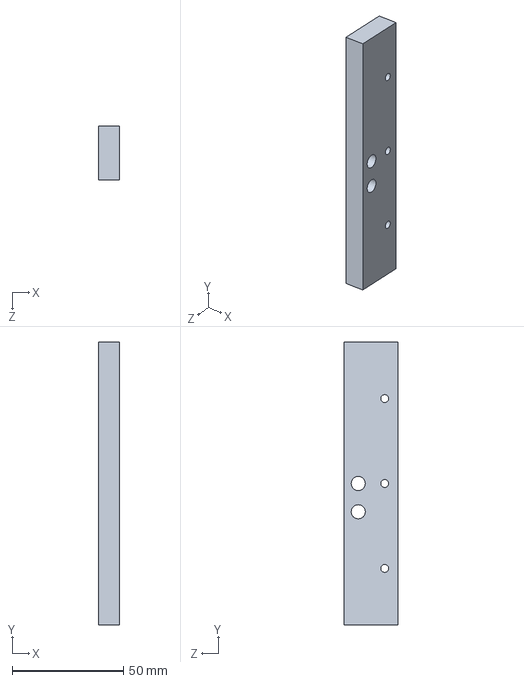
[picture p171: CAD file, 2015-03-01]
portfolio/Documents/CAD/part placer asm/rack right plate.SLDPRT
9.53 x 127.0 x 24.1 mm
