enewhall/Mechatronics/portfolio/Documents/CAD/wire cutter/feeder pulley 1-32.DXF

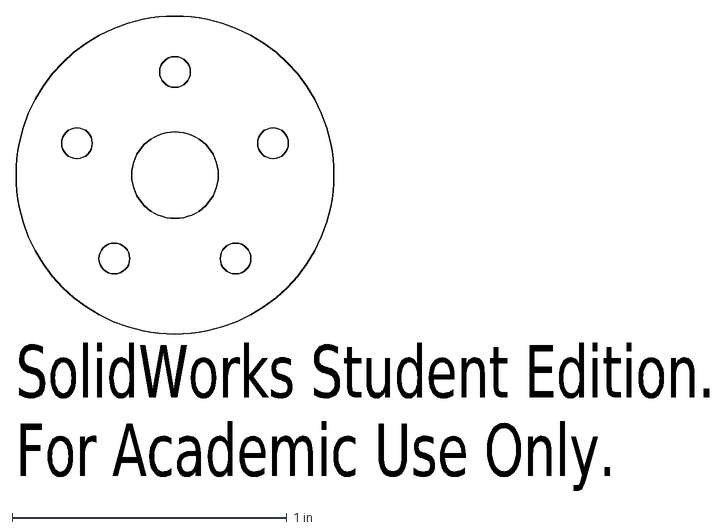
[picture p172: CAD file, 2015-04-01]
portfolio/Documents/CAD/wire cutter/feeder pulley 1-32.DXF
SolidWorks Student Edition.
For Academic Use Only.
