enewhall/Mechatronics/portfolio/Documents/CAD/flux-wire asm/rear rack brace l bracket.SLDPRT

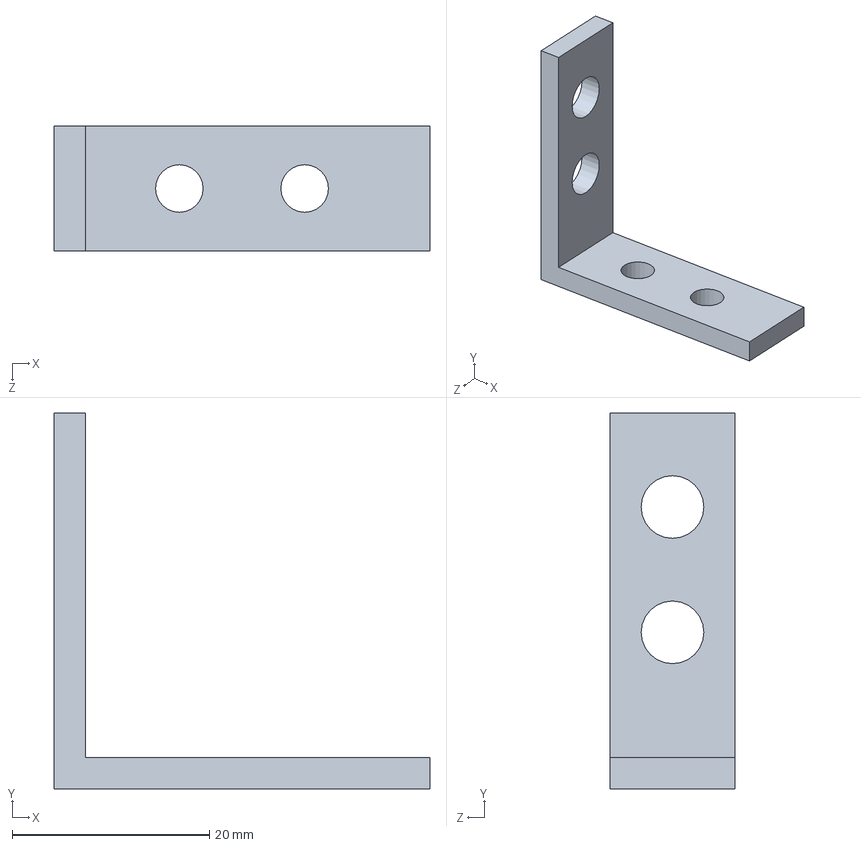
[picture p173: CAD file, 2015-03-21]
portfolio/Documents/CAD/flux-wire asm/rear rack brace l bracket.SLDPRT
38.1 x 38.1 x 12.7 mm
