enewhall/Mechatronics/portfolio/Documents/CAD/l-bracket flux.SLDPRT

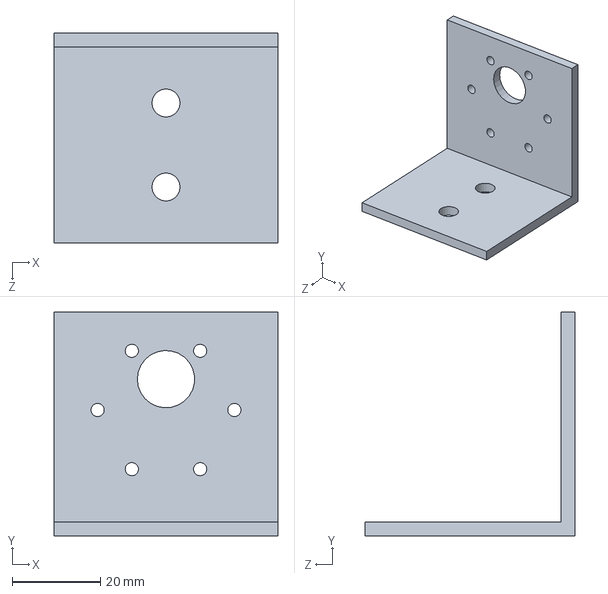
[picture p174: CAD file, 2015-03-01]
portfolio/Documents/CAD/l-bracket flux.SLDPRT
50.8 x 50.8 x 47.6 mm
