enewhall/Mechatronics/portfolio/Documents/CAD/part placer asm/rear motor plate.SLDPRT

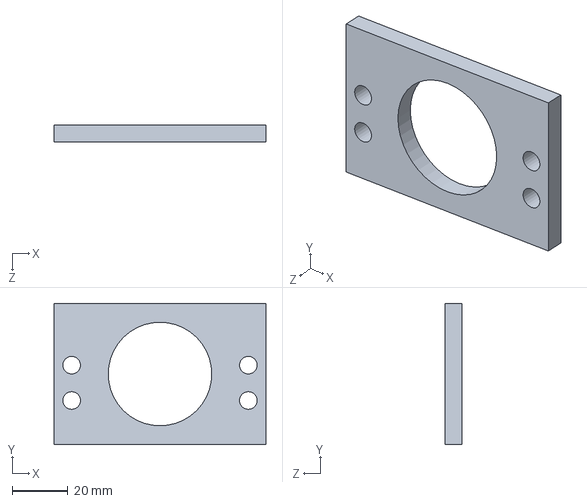
[picture p175: CAD file, 2015-03-01]
portfolio/Documents/CAD/part placer asm/rear motor plate.SLDPRT
76.2 x 50.8 x 5.99 mm
