enewhall/Mechatronics/portfolio/Documents/CAD/wire cutter/v2 arcyrlic spacer.SLDPRT

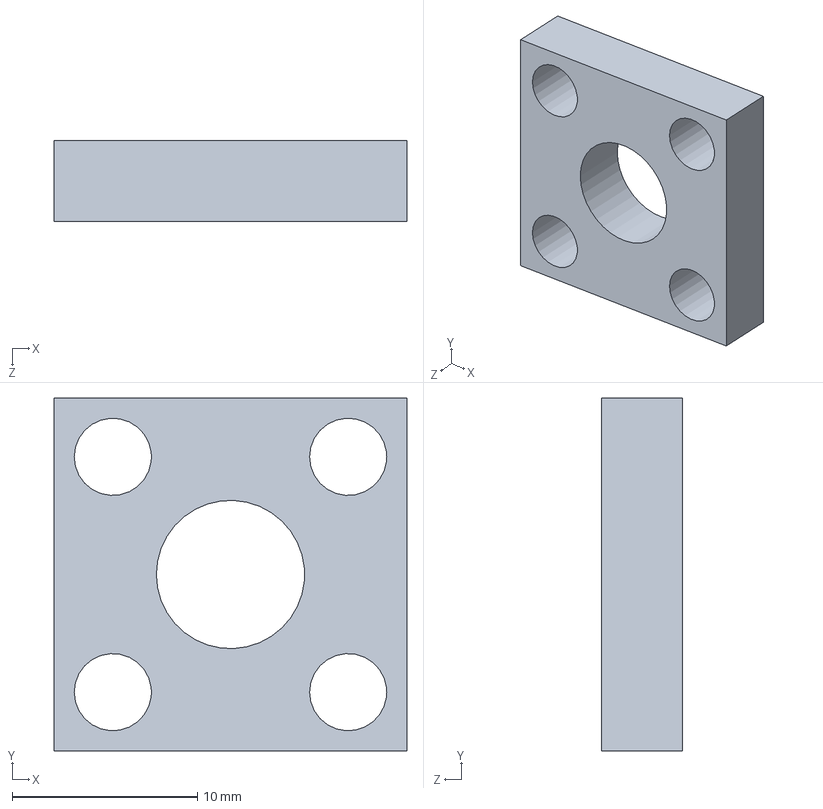
[picture p176: CAD file, 2015-03-23]
portfolio/Documents/CAD/wire cutter/v2 arcyrlic spacer.SLDPRT
19.1 x 19.1 x 4.39 mm
