enewhall/Mechatronics/portfolio/Documents/CAD/flux-wire asm/large 8mm standoff.SLDPRT

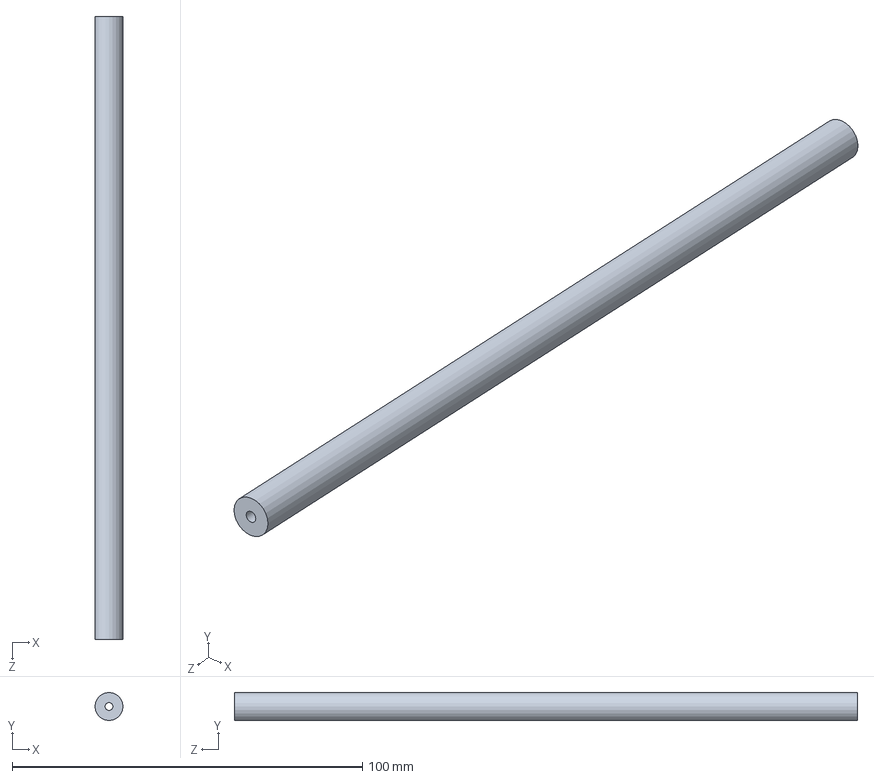
[picture p177: CAD file, 2015-03-21]
portfolio/Documents/CAD/flux-wire asm/large 8mm standoff.SLDPRT
8.00 x 8.00 x 177.8 mm
