enewhall/Mechatronics/portfolio/Documents/CAD/L-bracket belt mount.SLDPRT

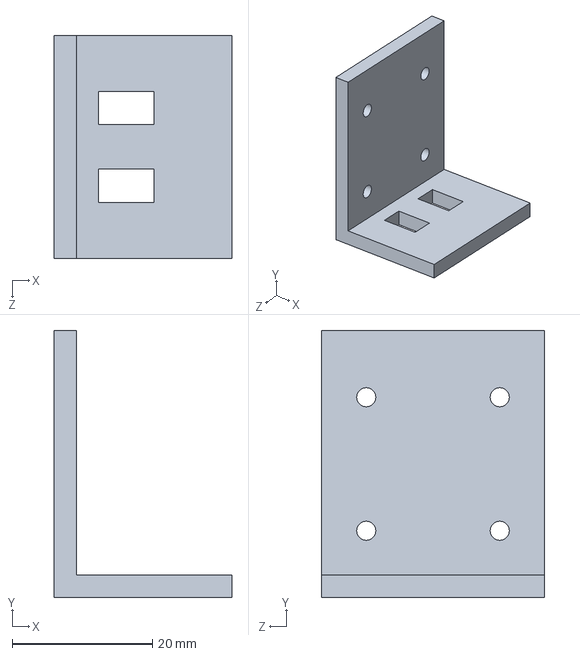
[picture p178: CAD file, 2015-03-01]
portfolio/Documents/CAD/L-bracket belt mount.SLDPRT
25.4 x 38.1 x 31.8 mm
