enewhall/Mechatronics/portfolio/Documents/CAD/wire cutter/feeder pulley.SLDPRT

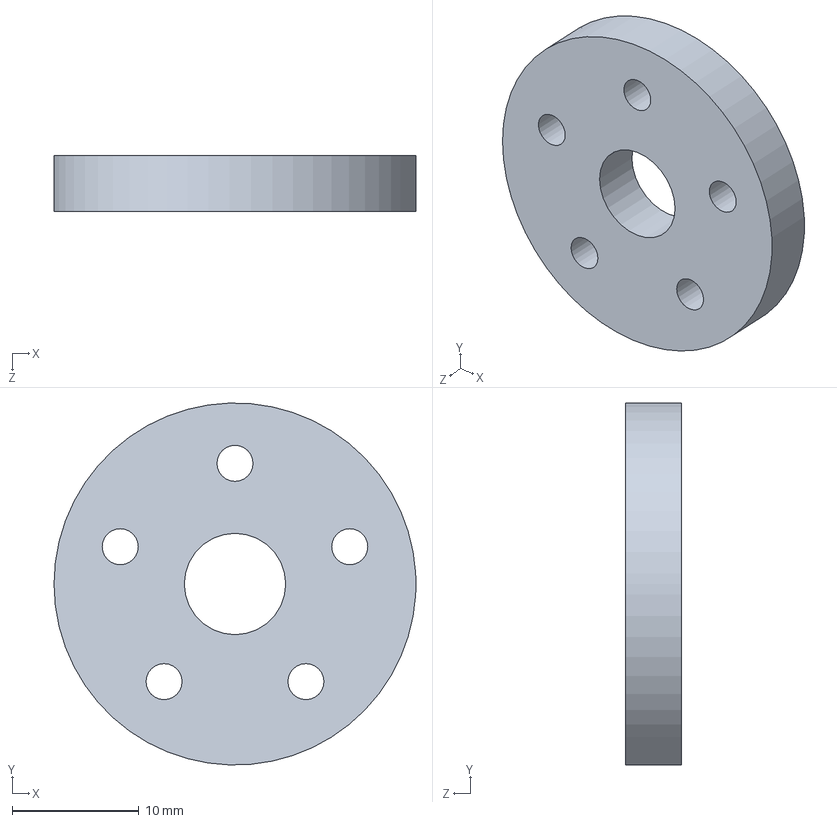
[picture p179: CAD file, 2015-03-23]
portfolio/Documents/CAD/wire cutter/feeder pulley.SLDPRT
28.6 x 28.6 x 4.39 mm
