enewhall/Mechatronics/portfolio/Documents/CAD/flux-wire asm/syringe piston.SLDPRT

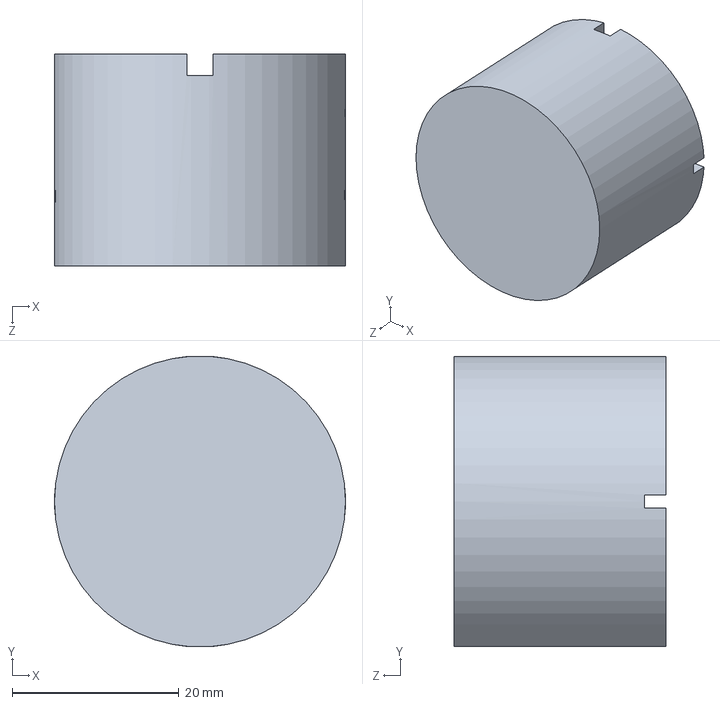
[picture p180: CAD file, 2015-03-21]
portfolio/Documents/CAD/flux-wire asm/syringe piston.SLDPRT
34.9 x 34.9 x 25.4 mm
