enewhall/Mechatronics/portfolio/Documents/CAD/part placer asm/.173 spacerx2.SLDPRT

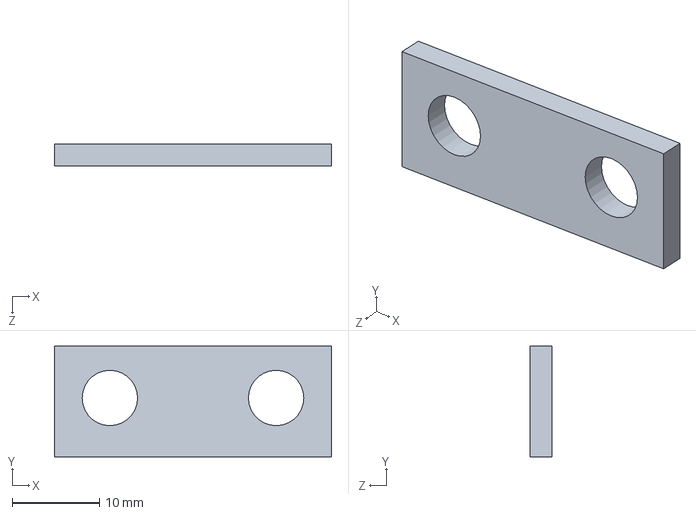
[picture p181: CAD file, 2015-03-01]
portfolio/Documents/CAD/part placer asm/.173 spacerx2.SLDPRT
31.8 x 12.7 x 2.54 mm
