enewhall/Mechatronics/portfolio/Documents/CAD/tabletop.SLDPRT

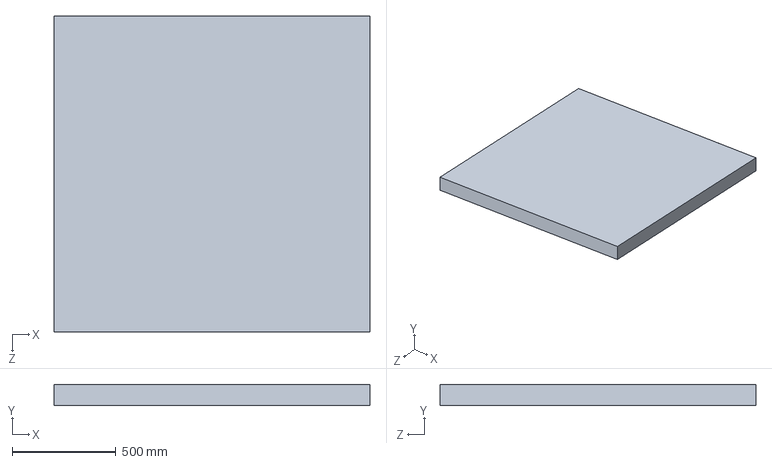
[picture p182: CAD file, 2015-02-16]
portfolio/Documents/CAD/tabletop.SLDPRT
1524.0 x 101.6 x 1524.0 mm
