enewhall/Mechatronics/portfolio/Documents/CAD/flux-wire asm/syringe acrylic mount.SLDPRT

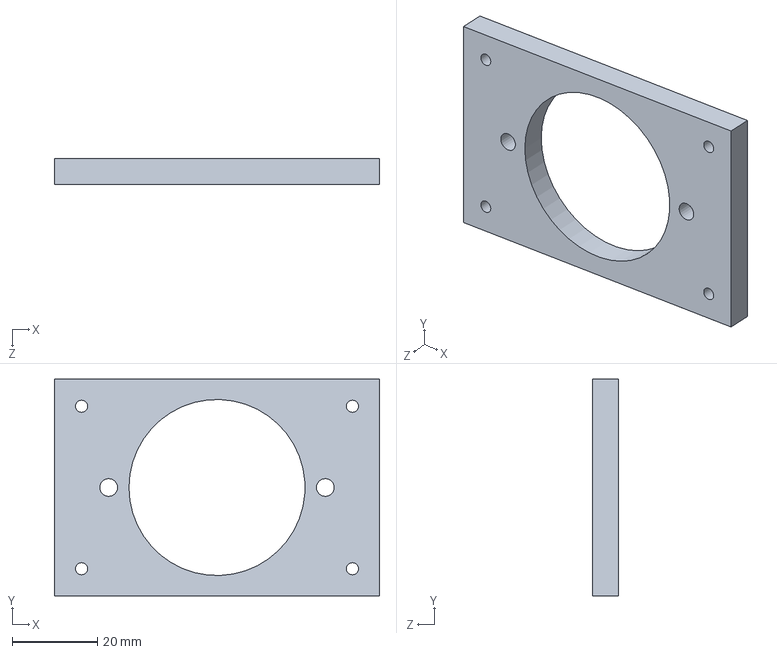
[picture p183: CAD file, 2015-03-21]
portfolio/Documents/CAD/flux-wire asm/syringe acrylic mount.SLDPRT
76.2 x 50.8 x 5.99 mm
