enewhall/Mechatronics/portfolio/Documents/CAD/part placer asm/middle electromagnet.SLDPRT

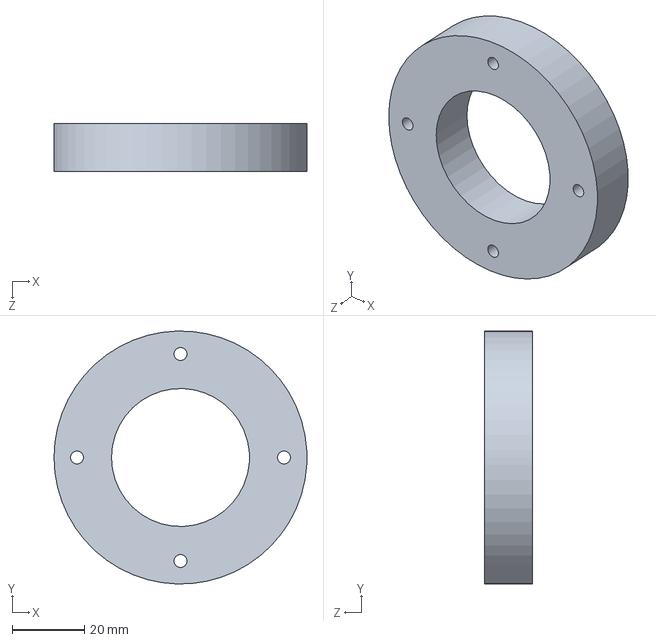
[picture p184: CAD file, 2015-03-01]
portfolio/Documents/CAD/part placer asm/middle electromagnet.SLDPRT
69.8 x 69.8 x 13.2 mm
