enewhall/Mechatronics/portfolio/Documents/CAD/wire cutter/shaft aligner.SLDPRT

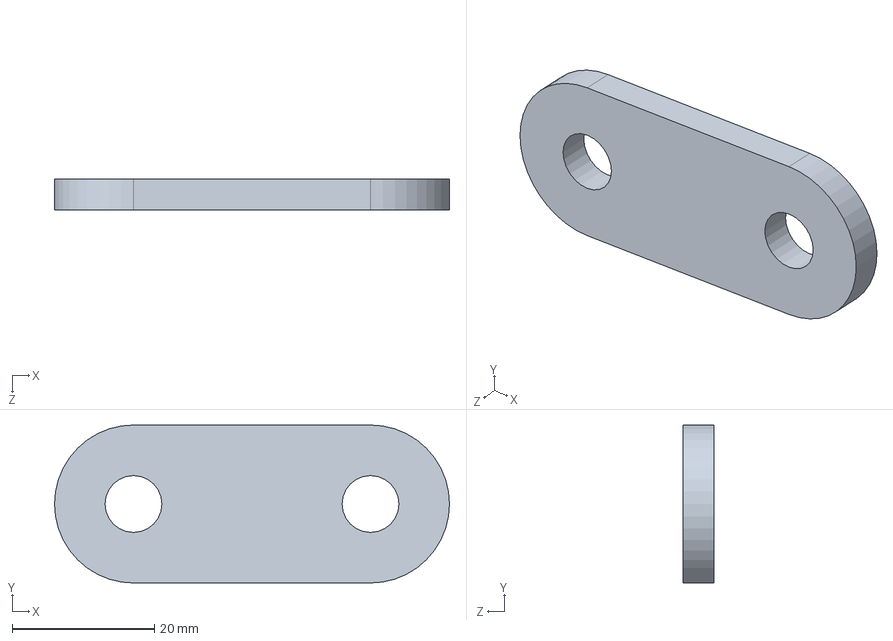
[picture p185: CAD file, 2015-03-23]
portfolio/Documents/CAD/wire cutter/shaft aligner.SLDPRT
55.6 x 22.2 x 4.39 mm
