enewhall/Mechatronics/portfolio/Documents/CAD/flux-wire asm/wire tube servo mount v2.SLDPRT

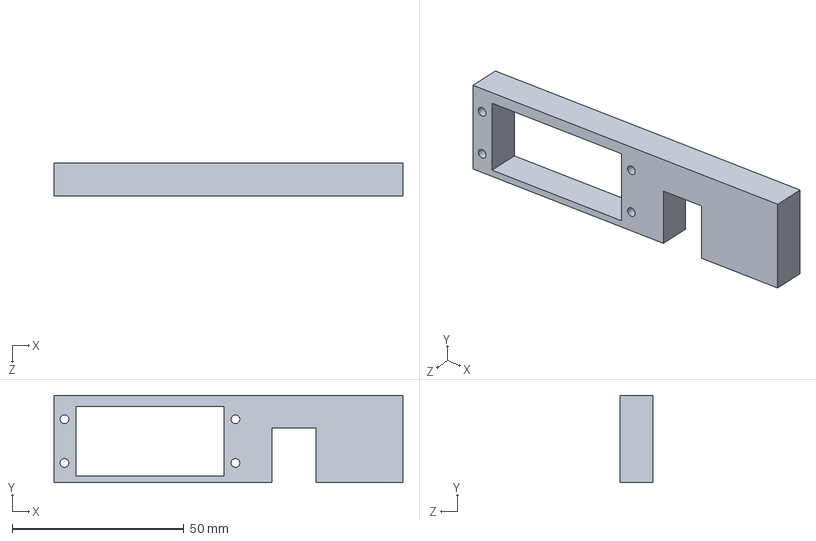
[picture p186: CAD file, 2015-03-21]
portfolio/Documents/CAD/flux-wire asm/wire tube servo mount v2.SLDPRT
101.6 x 25.4 x 9.53 mm
