enewhall/Mechatronics/portfolio/Documents/CAD/part placer asm/plate.DXF

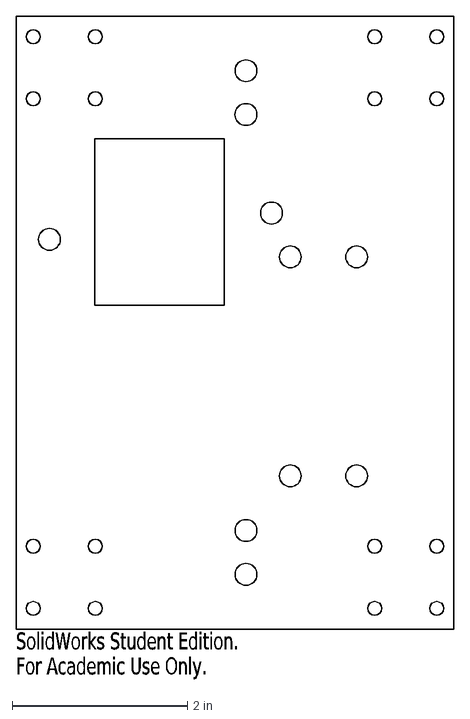
[picture p187: CAD file, 2015-03-01]
portfolio/Documents/CAD/part placer asm/plate.DXF
SolidWorks Student Edition.
For Academic Use Only.
