enewhall/Mechatronics/portfolio/Documents/CAD/wire cutter/8mm gear.SLDPRT

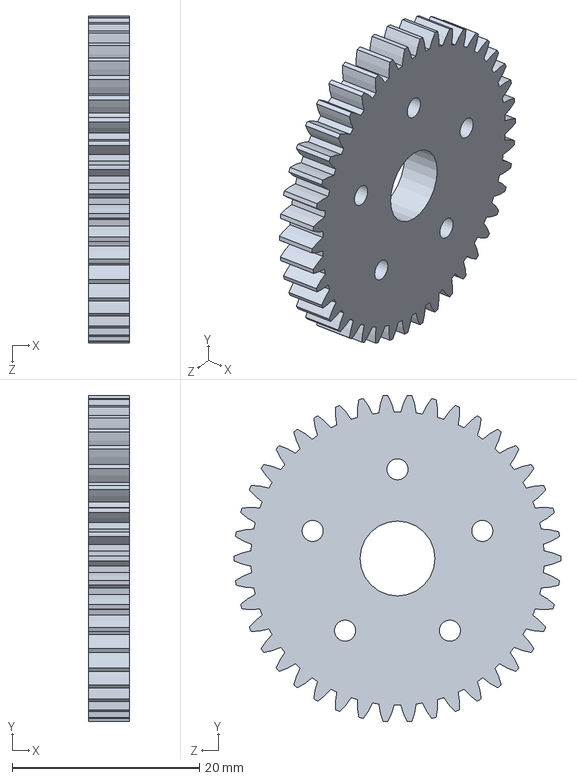
[picture p188: CAD file, 2015-03-23]
portfolio/Documents/CAD/wire cutter/8mm gear.SLDPRT
4.39 x 34.9 x 34.9 mm
