enewhall/Mechatronics/portfolio/Documents/CAD/flux-wire asm/front motor plate-flux extruder.SLDPRT

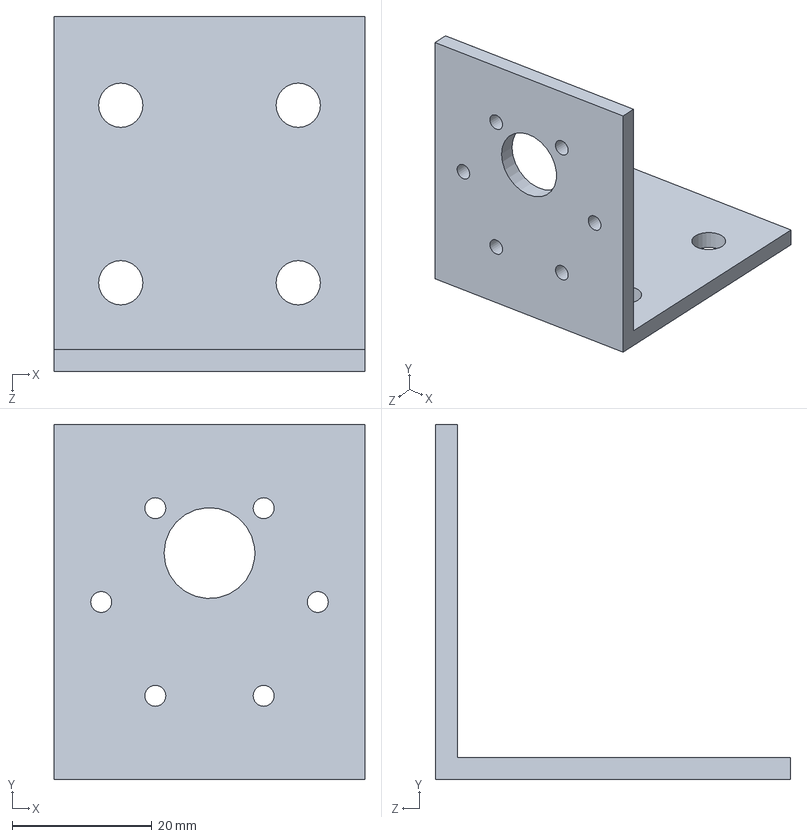
[picture p189: CAD file, 2015-03-21]
portfolio/Documents/CAD/flux-wire asm/front motor plate-flux extruder.SLDPRT
44.5 x 50.8 x 50.8 mm
