enewhall/Mechatronics/portfolio/Documents/CAD/part placer asm/front motor plate2.SLDPRT

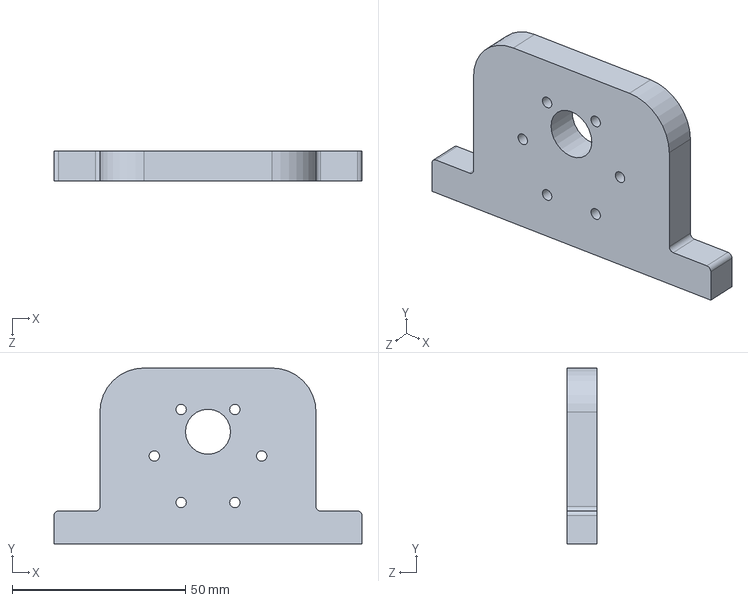
[picture p190: CAD file, 2015-03-01]
portfolio/Documents/CAD/part placer asm/front motor plate2.SLDPRT
88.9 x 50.8 x 8.64 mm
