enewhall/Mechatronics/portfolio/Documents/CAD/part placer asm/bottom electromagnet.SLDPRT

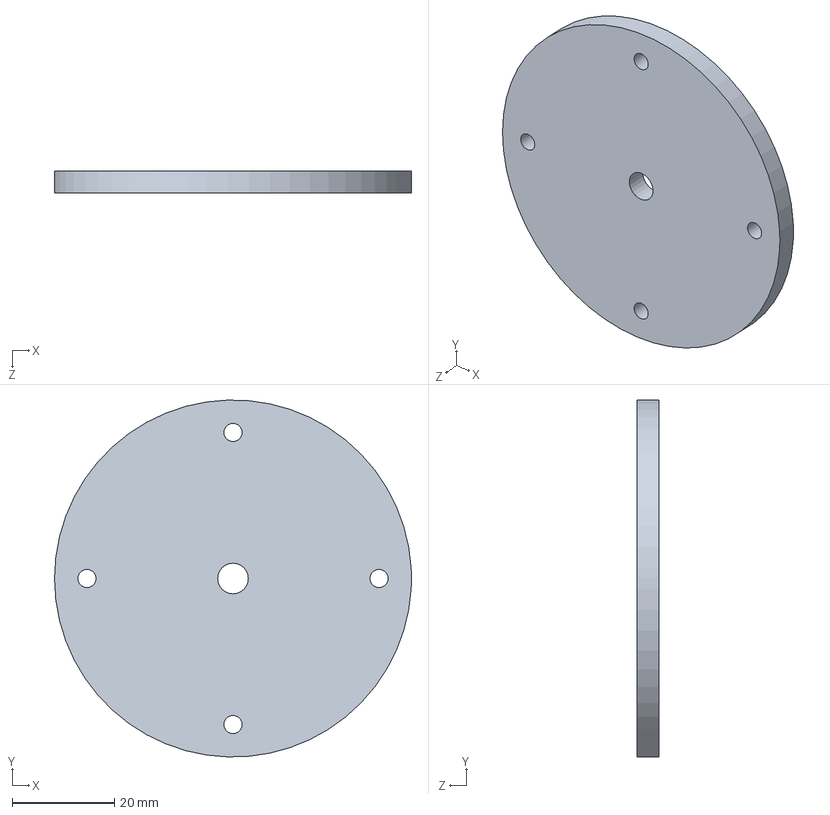
[picture p191: CAD file, 2015-03-01]
portfolio/Documents/CAD/part placer asm/bottom electromagnet.SLDPRT
69.8 x 69.8 x 4.39 mm
