enewhall/Mechatronics/portfolio/Documents/CAD/wire cutter/feed piece.SLDPRT

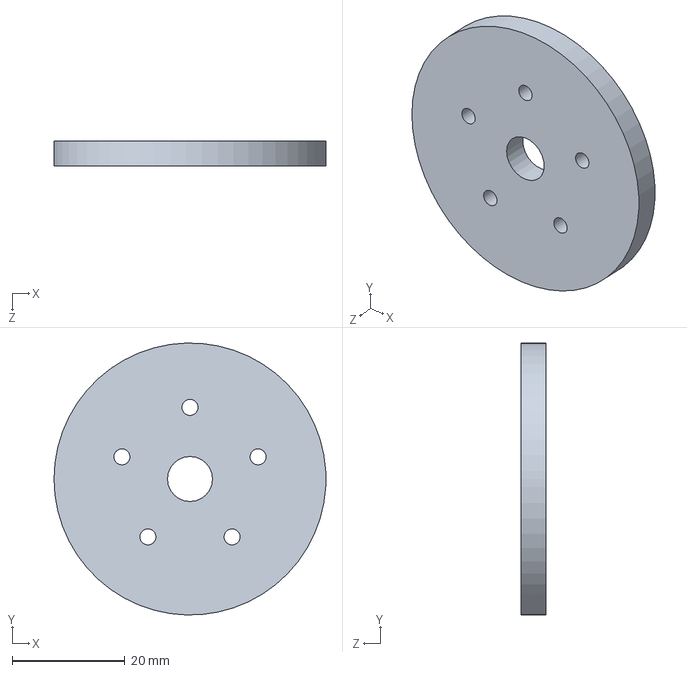
[picture p192: CAD file, 2015-03-21]
portfolio/Documents/CAD/wire cutter/feed piece.SLDPRT
48.3 x 48.2 x 4.39 mm
