enewhall/Mechatronics/portfolio/Documents/CAD/wire cutter/wire guide 1.SLDPRT

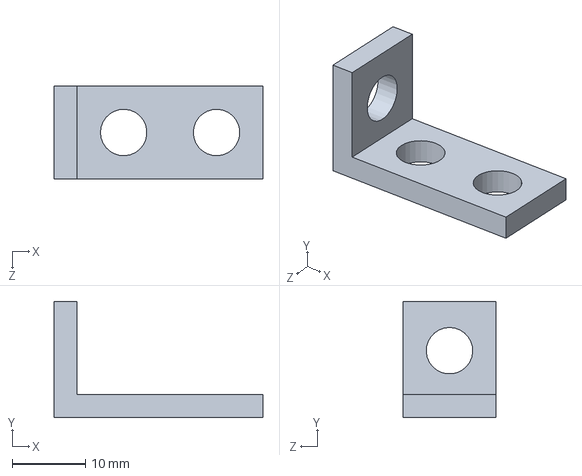
[picture p193: CAD file, 2015-03-21]
portfolio/Documents/CAD/wire cutter/wire guide 1.SLDPRT
28.6 x 15.9 x 12.7 mm
