enewhall/Mechatronics/portfolio/Documents/CAD/wire cutter/feed piece 8mm.DXF

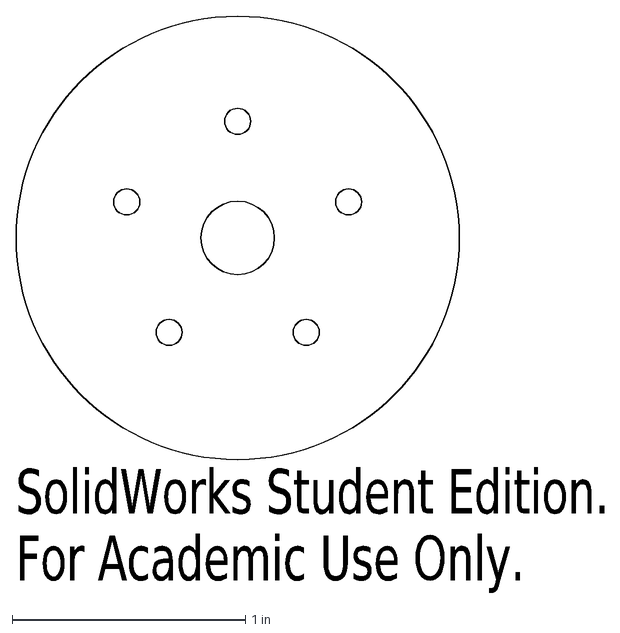
[picture p194: CAD file, 2015-03-21]
portfolio/Documents/CAD/wire cutter/feed piece 8mm.DXF
SolidWorks Student Edition.
For Academic Use Only.
