enewhall/Mechatronics/portfolio/Documents/CAD/wire cutter/8mm rod - wire feeder.SLDPRT

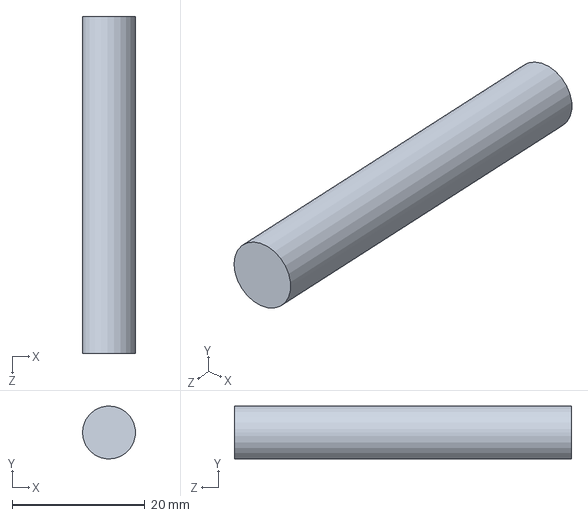
[picture p195: CAD file, 2015-03-21]
portfolio/Documents/CAD/wire cutter/8mm rod - wire feeder.SLDPRT
8.00 x 7.98 x 50.8 mm
