enewhall/Mechatronics/(list of files, cad)

Other CAD files:
portfolio/Documents/CAD/idler pulley/BEARING_5_16_5.sldprt
portfolio/Documents/CAD/Revolver_Subassembly/Revolver_35deg.SLDPRT
portfolio/Documents/CAD/Revolver_Subassembly/Revolver_30deg.SLDPRT
portfolio/Documents/CAD/L-bracket idler mount.SLDPRT
portfolio/Documents/CAD/L-bracket motor mount.SLDPRT
portfolio/Documents/CAD/part placer asm/linear bearing platform.SLDPRT
portfolio/Documents/CAD/wire cutter/v2 arcyrlic bottom piece.SLDPRT
portfolio/Documents/CAD/part placer asm/Linear Rail Shaft Guide.SLDPRT
portfolio/Documents/CAD/wire cutter/feed piece - rod.SLDPRT
portfolio/Documents/CAD/part placer asm/8mm rod.SLDPRT
portfolio/Documents/CAD/8020 frame/corner bracket.DXF
portfolio/Documents/CAD/Bolt Cutter Assembly.sldasm
portfolio/Documents/CAD/Revolver_Subassembly/Revolver_30deg.STL
portfolio/Documents/CAD/Revolver_Subassembly/Revolver_45deg.STL
portfolio/Documents/CAD/base asm/bottom plate.DXF
portfolio/Documents/CAD/base asm/middle plate.DXF
portfolio/Documents/CAD/base asm/top layer.DXF
portfolio/Documents/CAD/bolt cutter plate.SLDPRT
portfolio/Documents/CAD/flux-wire asm/flux rack.DXF
portfolio/Documents/CAD/flux-wire asm/flux-wire rails base.DXF
portfolio/Documents/CAD/flux-wire asm/gearmotor pinion.DXF
portfolio/Documents/CAD/flux-wire asm/rack back plate - flux.DXF
portfolio/Documents/CAD/flux-wire asm/rack side plates.DXF
portfolio/Documents/CAD/flux-wire asm/wire tube servo mount.DXF
portfolio/Documents/CAD/idler pulley/25197-02.stp
portfolio/Documents/CAD/idler pulley/B17023.sldprt
portfolio/Documents/CAD/idler pulley/B18026.sldprt
portfolio/Documents/CAD/part placer asm/.173 spacerx2.DXF
portfolio/Documents/CAD/part placer asm/front motor plate.DXF
portfolio/Documents/CAD/part placer asm/rack back plate.DXF
portfolio/Documents/CAD/part placer asm/rack left plate.DXF
portfolio/Documents/CAD/part placer asm/rack right plate.DXF
portfolio/Documents/CAD/part placer asm/rack.DXF
portfolio/Documents/CAD/part placer asm/rear motor plate.DXF
portfolio/Documents/CAD/part placer asm/servo mount.DXF
portfolio/Documents/CAD/wire cutter/8mm gear.DXF
portfolio/Documents/CAD/wire cutter/feed piece.DXF
portfolio/Documents/CAD/wire cutter/feeder pulley.DXF
portfolio/Documents/CAD/wire cutter/gearmotor gear.DXF
portfolio/Documents/CAD/wire cutter/shaft aligner.DXF
portfolio/Documents/CAD/wire cutter/v2 arcyrlic bottom piece.DXF
portfolio/Documents/CAD/wire cutter/v2 arcyrlic spacer.DXF
portfolio/Documents/CAD/wire cutter/wire feeder mounting plate.DXF
portfolio/Documents/CAD/wire cutter/wire feeder shaft aligner plate.DXF
