enewhall/Mechatronics/portfolio/Project_Management/Issues_Log/Issues_Log.html

# Mechatronics - Issues Log

16-778, 18-578, 24-778 Spring 2015
Group G
Eric Newhall (enewhall)
Guillermo Cidre (gmcidre)
Christian Heaney-Secord (cheaneys)
Michael O'Connor (mkoconno)

## Issues Log

Issue # | Date Discovered | Date Resolved | Change Made By | Origin | Description | Resolution | Artifacts Changed
enter Issue # | enter Date Discovered | enter Date Resolved | enter Change Made By | enter Origin | enter Description | enter Resolution | enter Artifacts Changed
