enewhall/Mechatronics/(commit log)

2015-02-01 IR Sensor Graph and data added to Lab section
    [IRsensor_values.ods]
2015-02-01 More notes and code for sensor lab
2015-02-06 Sensor Lab Bugfix
    Fix bug where it would double count the recent value. This is due to the
    fact that it stored the value first before moving the values down the
    array in the for loop. So, when it reached the for loop, the array 0 0 0
    0 x would become 0 0 0 x x.
    [SensorLab.ino]
2015-02-09 Motor Lab sensor control code
2015-02-10 newer code for motor lab
2015-02-11 working encoders
2015-02-11 working motor lab code
2015-02-16 CAD update
    working on bottom plate
    [25197-02.stp, 8020-12in.SLDPRT, 8020-18in.SLDPRT, 8020-20in.SLDPRT, 8mm rod.SLDPRT, B17023.sldprt, B18026.sldprt, BEARING_5_16_5.sldprt]
2015-02-17 Code for System Demo 1
    Controlling the Stepper motor with a slider.
2015-02-19 Photo for rail
2015-02-20 extra coding and stuff
    contain the code for our current demo along with some attempts of making
    the GUI program standalone, which failed.
    [sketch_feb09a.ino]
2015-02-23 Revert "Nothing"
    This reverts commit ab5c23319f674d6e8bcf4a3f2a50ffc5a440b630.
    [mainwindow.cpp]
2015-02-23 Fixed Coding for GUI
    Erase a lot of useless files and fixed bug where the program would use a
    file that did not exist.
    [mainwindow.cpp, mainwindow.h]
2015-02-24 added raspberry pi/arduino communicator.
2015-02-24 Third slider fix
    bug where value would be received from second instead of third. there is
    probably a wiring bug on my circuit that needs to be fixed.
    [mainwindow.cpp, sketch_feb09a.ino]
2015-02-27 Serial GUI/raspberry pi code for now. and my ILR
2015-03-01 CAD updates
    Updated cad models
    [.173 spacerx2.DXF, .173 spacerx2.SLDPRT, 8020-12in.SLDPRT, 8mm rod.SLDPRT, L-bracket belt mount.SLDPRT, L-bracket idler mount-part placer.SLDPRT, L-bracket idler mount.SLDPRT, L-bracket motor mount-part placer.SLDPRT]
2015-03-01 mkoconno IRL 1-4
    pdfs of first 4 IRLs for Mike
    [V2.SLDASM, part placer asm.SLDASM, rails_asm-bottom.SLDASM, rails_asm.SLDASM]
2015-03-01 CAD changes
    [8020-12in.SLDPRT, 8020-18in.SLDPRT, 8020-20in.SLDPRT, 8mm rod.SLDPRT, B17023.sldprt, B18026.sldprt, BEARING_5_16_5.sldprt, L-bracket belt mount.SLDPRT]
2015-03-01 CAD changes
    [Bolt Cutter Assembly.sldasm, V2.SLDASM]
2015-03-08 implementation of an additional stepper and DC motor. Also possible way of implementing commands
2015-03-08 Changing Style of coding
    Changing from copying and pasting Code to for loop implementation of all
    Stepper and DC motors.
2015-03-16 Improved arduino code working. +GUI mod
    ensured the for loop code worked and modified the GUI so that it follow
    the arduino code standards.
2015-03-17 arduino led code for raspberry orientator
2015-03-17 improvements to LED Orientation Display code
2015-03-21 flux extruder mostly
    random cad updates
    [8mm gear.DXF, 8mm gear.SLDPRT, 8mm rod - wire feeder.SLDPRT, Bolt Cutter Assembly.sldasm, Nema 23 stepper.SLDPRT, V2.SLDASM, acrylic motor mount.SLDPRT, bolt cutter plate.SLDPRT]
2015-03-21 updating GUI to incorporate a stepper move test
2015-03-21 added servo control into the arduino code.
2015-03-23 CAD Updates
    [Revolver_30deg.SLDPRT, Revolver_30deg.STL, Revolver_35deg.SLDPRT, Revolver_45deg.SLDPRT, Revolver_45deg.STL, Revolver_motor_plate.SLDPRT, Revolver_motor_plate2.SLDPRT, Revolver_motor_plate_middle.SLDPRT]
2015-03-23 wire feed asm update
    [8mm gear.DXF, 8mm gear.SLDPRT, Nema 23 stepper.SLDPRT, V2.SLDASM, feed mounting plate v2.DXF, feed mounting plate v2.SLDPRT, feeder asm v2.SLDASM, feeder pulley.DXF]
2015-03-25 improved the GUI
    The gui now can modify up to ten motors of each type(aka: stepper, DC,
    and Servo).
2015-03-30 code for stepper motor
2015-03-31 New stepper control test code
2015-03-31 Added standard for pin layout
2015-04-01 IRL and some cad
    [Part2.DXF, Part3.DXF, feeder pulley 1-16.DXF, feeder pulley 1-32.DXF, feeder spacer guide.DXF, gearmotor gear.DXF, gearmotor gear.SLDPRT, vertical shit.DXF]
2015-04-08 current encoder/flux code for project
2015-04-11 servo stuff
2015-04-11 Fixed servo Problem and test out the spinners
    [partPlac.ino]
2015-04-14 inserted current computer vision code on demo 8
2015-04-17 current code
2015-04-18 camera state chart
2015-04-18 custom stepper library
2015-04-20 LED codes and wait for serial to begin task
2015-04-20 fixed a part placer bug and other stuff
    the bug was that the part placer would always rotate the piece. The
    other stuff is the revReloading and the fluxDisp State have been
    implemented in partPlacer.ino
    [partPlac.ino, partPlacer.ino]
2015-04-21 final project without the camera test
2015-04-22 Revert "fadgfsr"
    This reverts commit aefab886a94eb8eaf8893c59d2d1bb967828864c.
    [partPlac.ino]
2015-04-22 current Demo code
2015-04-23 current Tester code
    Code use for testing the stepper motors.
2015-04-26 Remade part of the code for final demo
    Each of the file contains part of each subsystem code. In addition,
    structs are utilized to make the code look simpler and easier to
    implement. Only the partplacerstate.ino and the supportfunctionsStructs
    are currently implemented with tray and part stepper active. the magnets
    and servos for the part placer are also implemented
2015-04-26 current code so far
2015-04-27 finished seperating the code into files
    The camera state code is suboptimal, and therefore need to be rewritten.
2015-04-27 current code
    PreTinnerSoftware set to test the revRelState and the fluxDispState.
    placTester will toggle the servo position.
2015-04-27 New Servo Constants (IMPORTANT!)
2015-04-27 updated servo values in final code
2015-05-01 magnet quick fix (not tested)
    [CameraState.ino, PreTinnerSoftware.ino]
2015-05-03 camera code(outdated) but close to real code
2015-05-04 Current code
    It currently runs all the states but not the revRelState. To enable it,
    uncomment the revLoop() statement on the pretinnersoftware.ino. If
    running revRel, remove the fluxDispState line.
